ni0x0/diploma/Documentation/some_presentation_materials/1q.png

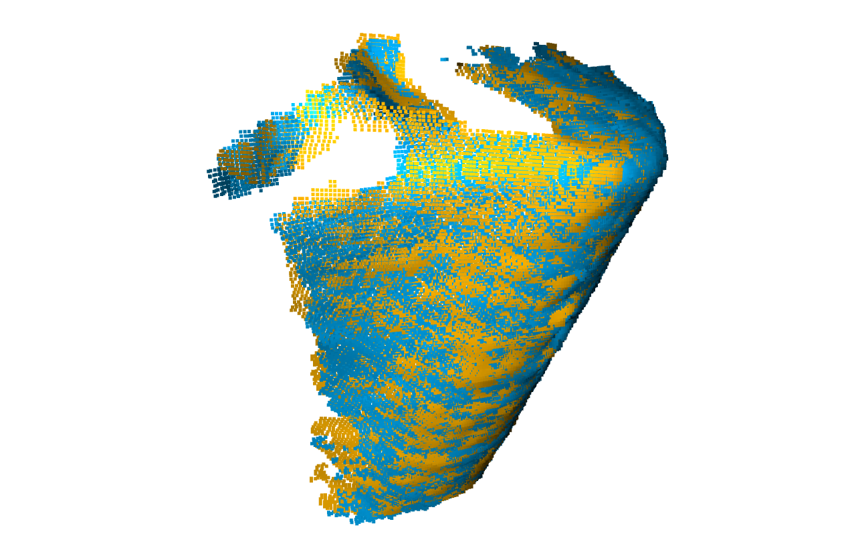
Documentation/some_presentation_materials/1q.png
