ni0x0/diploma/Documentation/some_presentation_materials/screen4.png

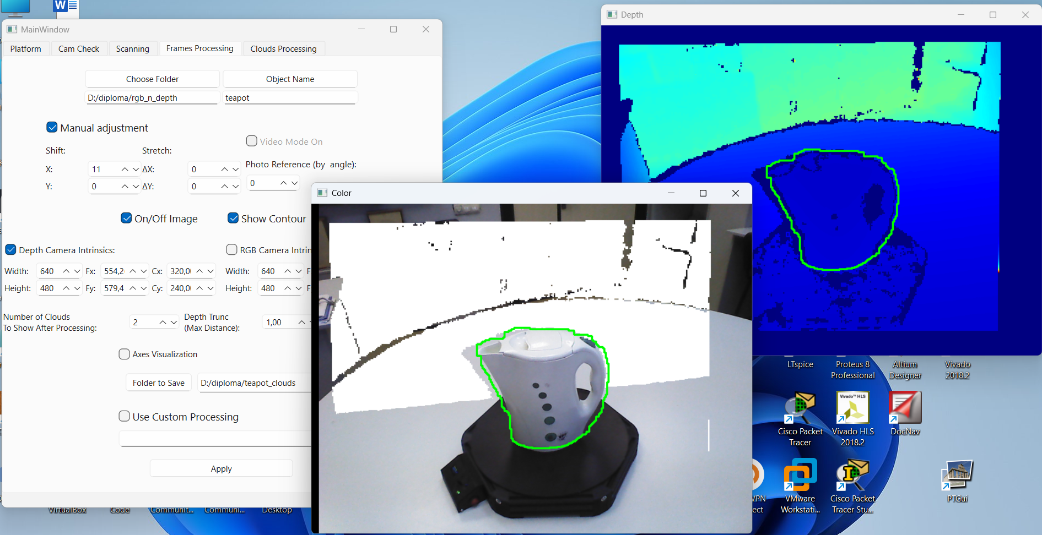
Documentation/some_presentation_materials/screen4.png
