ni0x0/diploma/3d_models_corrections/Readme.md

Тут именно мои модельки. Ссылки на оригиналы есть в записке
