ni0x0/diploma/Documentation/DiplomaNotes/11_Перечень элементов_2025.pdf

Изм. Лист | | № докум. | Подп. | Дата
Разраб. | Черноок | | | Программно-аппаратный комплекс для 3D сканирования объектов. Перечень элементов | Лит. | Лист | Листов
Пров. | Перцев | | | | | Т | | 1 | 2
Т. контр. | Перцев | | | | ЭВМ, гр. 150501
Н. контр. | Стракович
Утв. | Никульшин

## ГУИР.400201.099 ПЭ3

Поз. чение Зона обозна- | Наименование | Кол. | Примечание
| Конденсаторы
C1 | Конденсатор электролитический выводной 47uF
| 100V 10x12,5 105C / JRB2A470M05001000125000B | 1
С2 | Конденсатор многослойный 0.1uF 50V (Y5V) ±20%/
| TS170R1H104M8BFB0R | 1
C3 | Конденсатор электролитический выводной 100uF
| 16V 5x11 105C (JWCO) | 1
| Микросхемы
DD1 | DSM-OLEDv2-0.96-4P-YB, 0.96-дюймовый модуль с
| дисплеем OLED | 1
DD2 | Субмодуль DRV8825 / драйвер шагового
| двигателя | 1
DD3 | BMS 3S (12.6В 40A BALANCE) контроллер заряда
| с защитой и балансировкой на 3 АКБ | 1
DD4 | Модуль WROOM ESP32-S WiFi 4MB, 38 контактов | 1
DD5 | Модуль Mini-360 понижающий DC-DC
| преобразователь напряжения | 1
| Двигатели
M1 | Шаговый мотор NEMA 17HS8401-01 54 мм, 2А | 1
| Индикаторы
HL1 | Светодиод выводной BT-104GID-31-520G-B6 /
| зелёный | 1
HL2 | Светодиод выводной GNL-5013UBD-B /
| синий | 1

Изм. Лист | № докум. | Подп. | Дата

## ГУИР.400201.099 ПЭ3

Поз. чение Зона обозна- | Наименование | Кол. | Примечание
| Резисторы
R1, R2 | Резистор выводной 10K 0.25W ±5 %, CF1, 4W-10K | 2
R3, R4 | Резистор выводной 470 0.25W ±5 % | 2
RP1 | Резистор переменный осевой R-0904N-B100K L20 | 1

Лист
2
| Разъемы
XT1 | Клеммник винтовой DG126-5.0-02P-14-00AH | 2
| Устройства коммутации
SA1 | Переключатель клавишный RS-7201-C-C3 / с
| фиксацией, 250VAC, без подсветки красный | 1
SW1, SW2 KAN1211-1001B 12x12x10 mm Кнопка тактовая | | 2
