ni0x0/diploma/sketches/Readme.md

Код рабочий, но чуть-чуть не полный (вроде нет обработки пары команд)
