ni0x0/diploma/Documentation/DiplomaNotes/01.ТЛ по ПДП_2025.docx

Министерство образования Республики Беларусь

Учреждение образования

БЕЛОРУССКИЙ ГОСУДАРСТВЕННЫЙ УНИВЕРСИТЕТ

ИНФОРМАТИКИ И РАДИОЭЛЕКТРОНИКИ

Факультет компьютерных систем и сетей

Кафедра электронных вычислительных машин

Отчет по преддипломной практике

Студент А.Ю. Черноок

Руководитель Е.Э. Лойкуц

Консультант от кафедры ЭВМ Д.Ю. Перцев

Нормоконтролер А.И. Стракович

МИНСК 2025
