ni0x0/diploma/Documentation/DiplomaNotes/02.ТЛ_2025.pdf

Министерство образования Республики Беларусь

Учреждение образования
БЕЛОРУССКИЙ ГОСУДАРСТВЕННЫЙ УНИВЕРСИТЕТ ИНФОРМАТИКИ И РАДИОЭЛЕКТРОНИКИ

Факультет компьютерных систем и сетей

Кафедра электронных вычислительных машин

К защите допустить:
Заведующий кафедрой ЭВМ
___________ Б.В. Никульшин

ПОЯСНИТЕЛЬНАЯ ЗАПИСКА
к дипломному проекту
на тему

ПРОГРАММНО-АППАРАТНЫЙ КОМПЛЕКС ДЛЯ 3D СКАНИРОВАНИЯ ОБЪЕКТОВ

БГУИР ДП 1–40 02 01 01 099 ПЗ

Студент | А.Ю. Черноок
Руководитель | Д.Ю. Перцев

Консультанты:

от кафедры ЭВМ | Д.Ю. Перцев
по экономической части | В.Г. Горовой
Нормоконтролер | А.И. Стракович

Рецензент

МИНСК 2025

Решением рабочей комиссии
допущен(а) к защите дипломного проекта Председатель рабочей комиссии

_______________ ( ___________________ )

Подпись | Инициалы и фамилия
«___» ________ 2025 г.
