ni0x0/diploma/Documentation/DiplomaNotes/05.плакат_2025.pdf

# ПРОГРАММНО-АППАРАТНЫЙ КОМПЛЕКС ДЛЯ 3D СКАНИРОВАНИЯ ОБЪЕКТОВ

## Цель проекта:

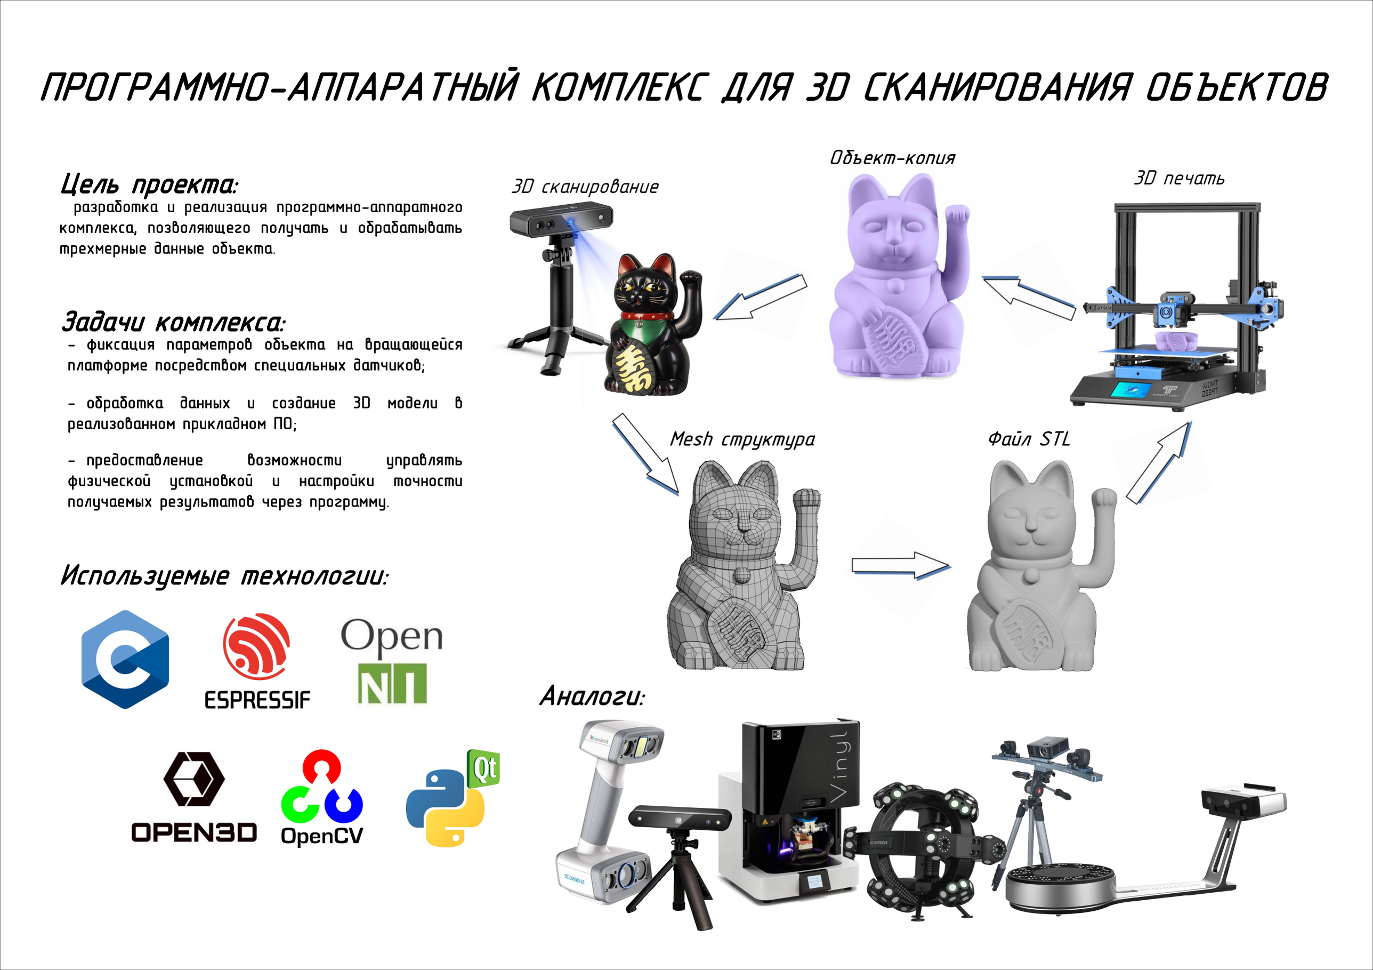
[picture p89: page 1]

## Используемые технологии:

## Аналоги:

### 3D сканирование

### 3D печать

Mesh структура | Файл STL

### Объект-копия

разработка и реализация программно-аппаратного комплекса, позволяющего получать и обрабатывать трехмерные данные объекта.

## Цель проекта:

разработка и реализация программно-аппаратного комплекса, позволяющего получать и обрабатывать трехмерные данные объекта.

## Задачи комплекса:

–шфиксация параметров объекта на вращающейся платформе посредством специальных датчиков;

–шпредоставление | возможности | управлять
физической | установкой | и | настройки | точности
получаемых результатов через программу.

–шобработка данных и создание 3D модели в реализованном прикладном ПО;

–шфиксация параметров объекта на вращающейся платформе посредством специальных датчиков;

–шпредоставление | возможности | управлять
физической | установкой | и | настройки | точности
получаемых результатов через программу.

–шобработка данных и создание 3D модели в реализованном прикладном ПО;

## Задачи комплекса:

–шфиксация параметров объекта на вращающейся платформе посредством специальных датчиков;

–шпредоставление | возможности | управлять
физической | установкой | и | настройки | точности
получаемых результатов через программу.

–шобработка данных и создание 3D модели в реализованном прикладном ПО;

## Цель проекта:

разработка и реализация программно-аппаратного комплекса, позволяющего получать и обрабатывать трехмерные данные объекта.

## Задачи комплекса:

–шфиксация параметров объекта на вращающейся платформе посредством специальных датчиков;

–шпредоставление | возможности | управлять
физической | установкой | и | настройки | точности
получаемых результатов через программу.

–шобработка данных и создание 3D модели в реализованном прикладном ПО;

| | | | | ГУИР.400201.099 ПЛ.1 ГУИР.400201.099 ПЛ.1
| | | | | Вводный плакат. Плакат Вводный плакат. Плакат | Лит. Лит. | Масса Масса | Масштаб Масштаб
Изм. | Лист Лист | № докум. № докум. | Подп. Подп. | Дата Дата | | | Т Т
Разраб. Разраб. | | Черноок Черноок
Пров. Пров. | | Перцев Перцев
Т. контр. Т. контр. | Перцев Перцев | | | | Лист Лист | Листов Листов 1 1
Реценз. Реценз. | | | | | ЭВМ, гр. 150501 ЭВМ, гр. 150501
Н. контр. Н. контр. | Стракович Стракович
Утв. Утв. | Никульшин Никульшин
