ni0x0/diploma/Documentation/DiplomaNotes/06_v2_структурная_x2.pdf

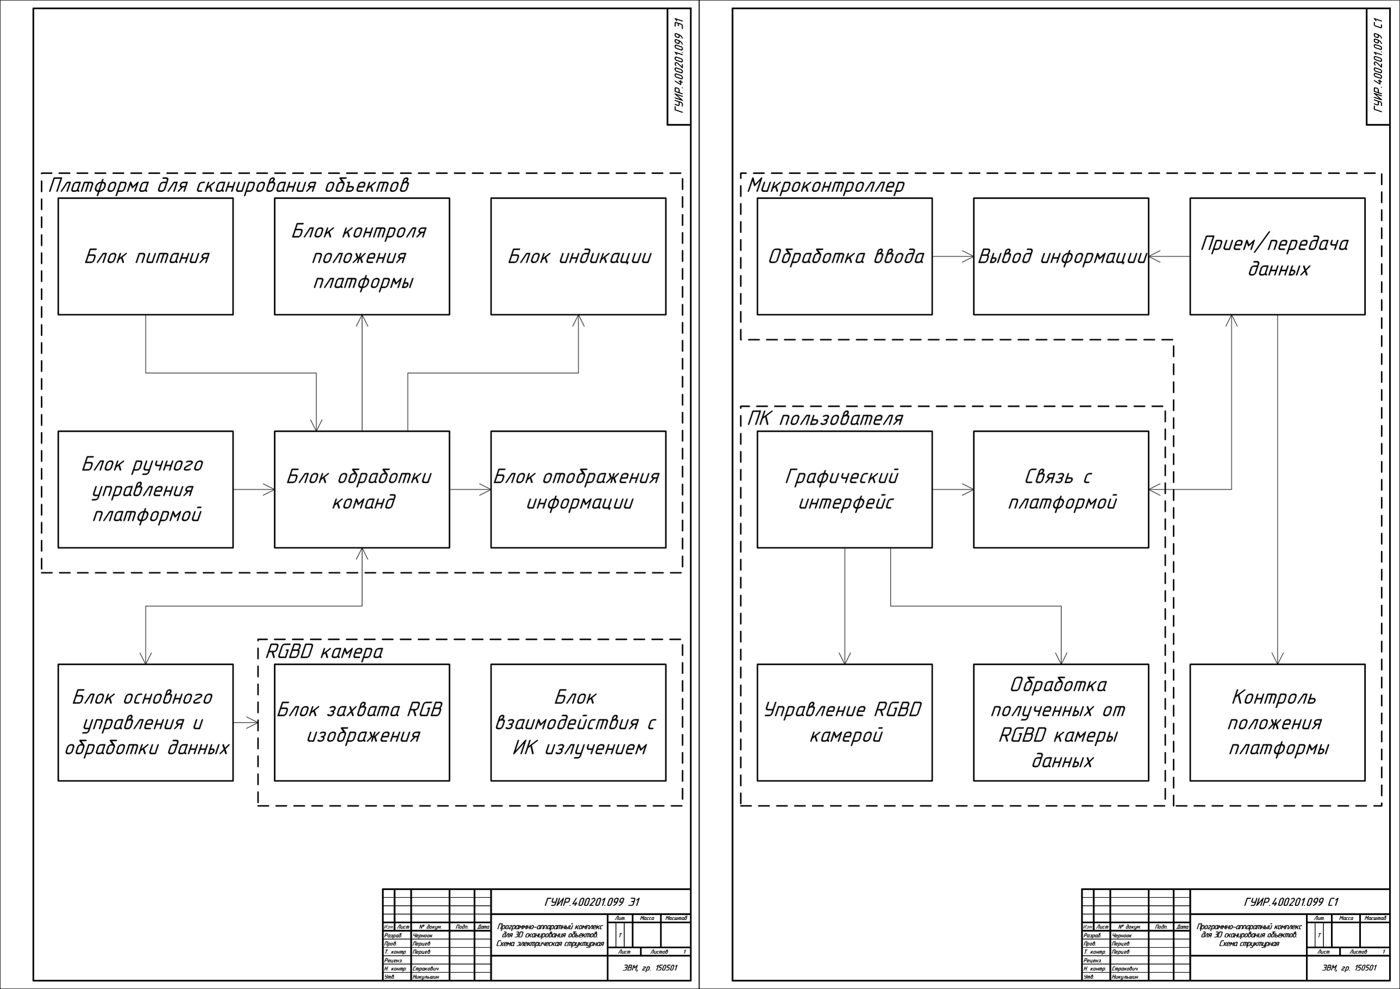
[picture p90: figure]
Лист; № докум.; Подп.; Дата; Разраб.; Пров.; Т. контр.; Н. контр.; Утв.; Черноок; Реценз.; Перцев; Программно-аппаратный комплекс для 3D сканирования объектов. Схема электрическая структурная; ГУИР.400201.099 Э1; Лит.; Масса; Масштаб; Листов; ЭВМ, гр. 150501; Стракович; Никульшин; Программно-аппаратный комплекс для 3D сканирования объектов. Схема структурная; ГУИР.400201.099 С1; Изм.; Блок индикации; Блок контроля положения платформы; Блок отображения информации; Блок обработки команд; Блок ручного управления платформой; Блок взаимодействия с ИК излучением; Блок захвата RGB изображения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
