ni0x0/diploma/Documentation/DiplomaNotes/12_монтажный.pdf

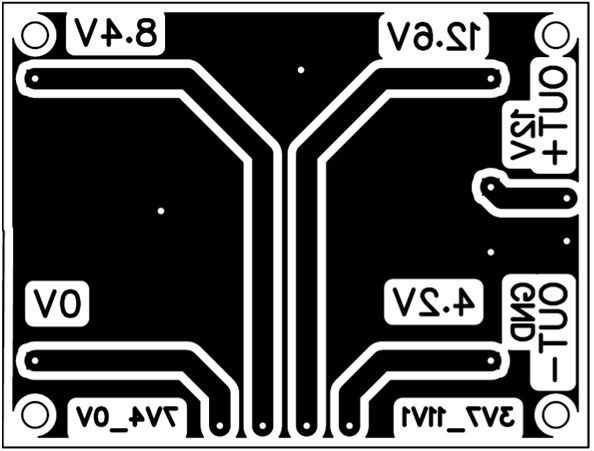
[picture p91: figure]
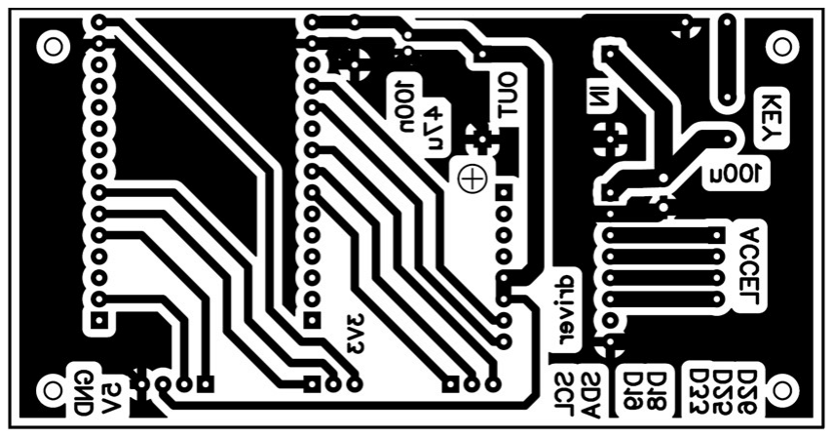
[picture p92: figure]
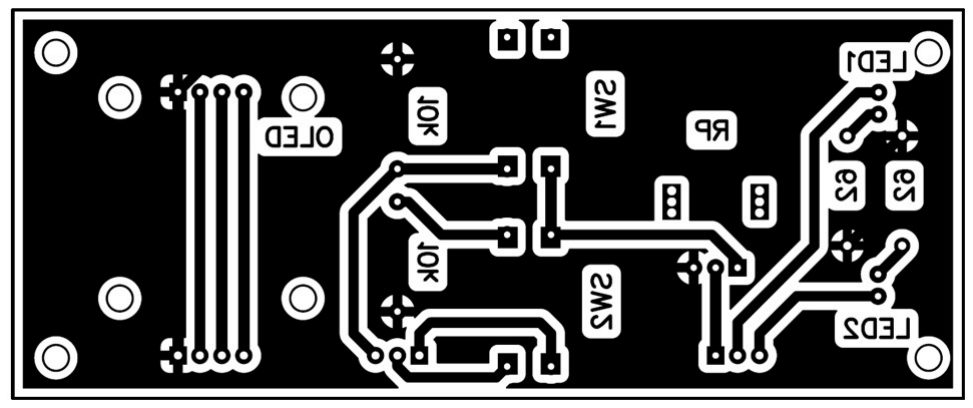
[picture p93: figure]

| | | | | ГУИР.400201.099 МЭ
| | | | | Программно-аппаратный комплекс для 3D сканирования объектов. Чертеж электромонтажный | Лит. | Масса | Масштаб
Изм. Лист | | № докум. | Подп. | Дата | | | Т | | 1:1
Разраб. | | Черноок
Пров. | | Перцев
Т. контр. | Перцев | | | | Лист | Листов 1
Реценз. | | | | | ЭВМ, гр. 150501
Н. контр. | Стракович
Утв. | Никульшин

Плата для установки BMS 3S

Плата с разведением питания и микроконтроллером

Плата «панели управления»
