ni0x0/diploma/Documentation/DiplomaNotes/13_Спецификация_2025.pdf

Изм. | Лист | № докум. | Подп. | Дата
Разраб. | Черноок | | | Программно-аппаратный комплекс для 3D сканирования объектов. Спецификация | Лит. | Лист | Листов
Пров. | Перцев | | | | | Т | | 1
Т. контр. | Перцев | | | | ЭВМ, гр. 150501
Н. контр. | Стракович
Утв. | Никульшин

## ГУИР.400201.099 Д2

Обозначение | Наименование | Примечание
| Документация
12-01 | Исходный код для | В составе пояснительной записки
| микроконтроллера
12-01 | | В составе пояснительной записки Исходный код
| прикладного ПО
81-01 | Пояснительная записка | В составе пояснительной записки
90-01 | Руководство пользователя | В составе пояснительной записки

Компоненты
3DScanPlatform.zip.
Архивный файл | На DVD-R диске «CharnavokAY»
3DScanPlatform_Source.zip.
Архивный файл | На DVD-R диске «CharnavokAY»
astra-win32-driver-4.3.0.22.zip.
Архивный файл | На DVD-R диске «CharnavokAY»
esp32.zip.
Архивный файл | На DVD-R диске «CharnavokAY»
presentation.pptx.
Мультимедийный файл | На DVD-R диске «CharnavokAY»
Readme.txt.
Текстовый файл | На DVD-R диске «CharnavokAY»
