ni0x0/diploma/Documentation/DiplomaNotes/14_Ведомость_2025.pdf

Изм. Лист | | № докум. | Подп. | Дата
Разраб. | Черноок | | | Программно-аппаратный комплекс для 3D сканирования объектов. Ведомость документов | Лит. | Лист | Листов
Пров. | Перцев | | | | | Т | | 1 | 2
Т. контр. | Перцев | | | | ЭВМ, гр. 150501
Н. контр. | Стракович
Утв. | Никульшин

## БГУИР ДП 1–40 02 01 099 Д1

Обозначение | Наименование | Примечание
| Графические документы
ГУИР.400201.099 МЭ | Программно-аппаратный комплекс для 3D
| сканирования объектов. | Формат А4,
| Чертеж электромонтажный | в ПЗ
ГУИР.400201.099 ПД.1 | Программно-аппаратный комплекс для 3D
| сканирования объектов: ПО микроконтроллера.
| Схема программы | Формат А1
ГУИР.400201.099 ПД.2 | Программно-аппаратный комплекс для 3D
| сканирования объектов: прикладное ПО.
| Схема программы | Формат А1
ГУИР.400201.099 ПЛ.1 | Вводный плакат. Плакат | Формат А1
ГУИР.400201.099 ПЛ.2 | Заключительный плакат. Плакат | Формат А1
ГУИР.400201.099 С1 | Программно-аппаратный комплекс для 3D
| сканирования объектов.
| Схема структурная | Формат А2
ГУИР.400201.099 Э1 | Программно-аппаратный комплекс для 3D
| сканирования объектов.
| Схема электрическая структурная | Формат А2
ГУИР.400201.099 Э2 | Программно-аппаратный комплекс для 3D
| сканирования объектов.
| Схема электрическая функциональная | Формат А2
ГУИР.400201.099 Э3 | Программно-аппаратный комплекс для 3D
| сканирования объектов.
| Схема электрическая принципиальная | Формат А2
| Текстовые документы
БГУИР ДП 1–400201 01 099 ПЗ | | 151 с. Пояснительная записка

Изм. Лист | № докум. | Подп. | Дата

## БГУИР ДП 1–40 02 01 099 Д1

Лист
2
Обозначение | Наименование | Примечание
ГУИР.400201.099 Д2 | Программно-аппаратный комплекс для 3D
| сканирования объектов.
| Спецификация | 1 л., в ПЗ
ГУИР.400201.099 ПЭ3 | Программно-аппаратный комплекс для 3D
| сканирования объектов.
| Перечень элементов | 2 л., в ПЗ
| Отзыв руководителя
| Отчет проверки на заимствования
| Рецензия
