ni0x0/diploma/Documentation/DiplomaNotes/15_закл_плакат_2025.pdf

# ПРОГРАММНО-АППАРАТНЫЙ КОМПЛЕКС ДЛЯ 3D СКАНИРОВАНИЯ ОБЪЕКТОВ

## Достоинства:

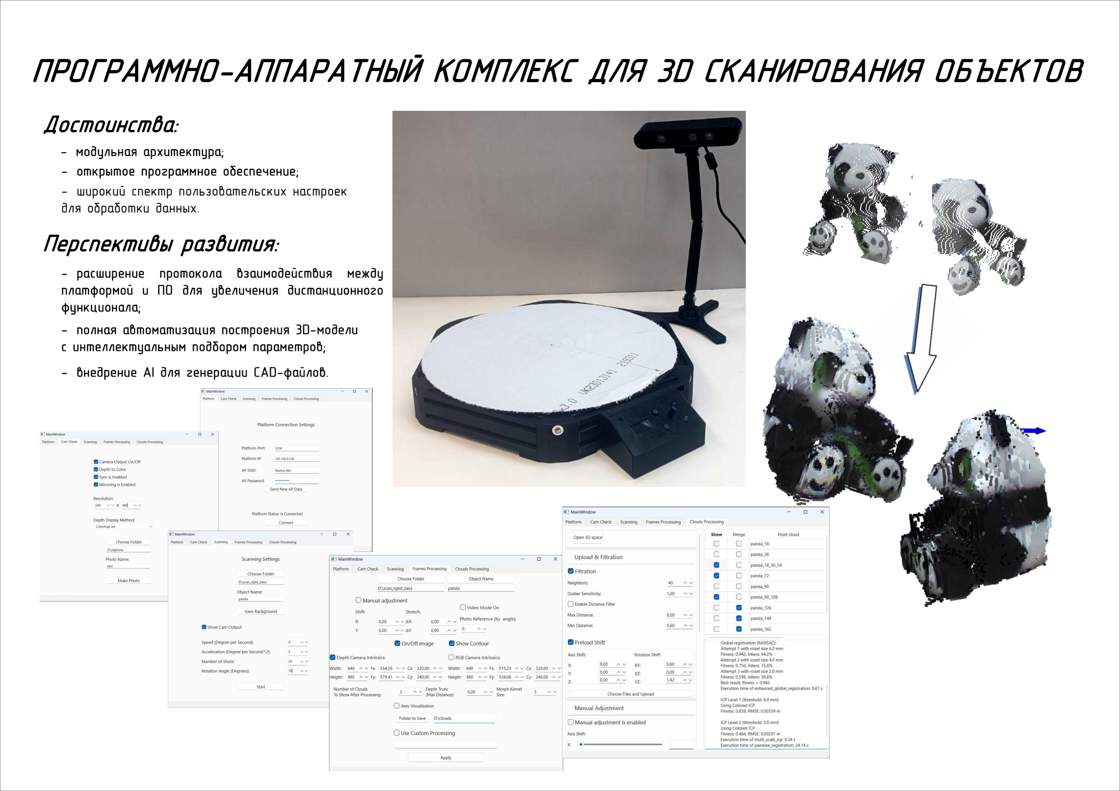
[picture p94: page 1]

## Перспективы развития:

–шрасширение протокола взаимодействия между платформой и ПО для увеличения дистанционного функционала;

–швнедрение AI для генерации CAD-файлов.

–шполная автоматизация построения 3D-модели
с интеллектуальным подбором параметров;

–шрасширение протокола взаимодействия между платформой и ПО для увеличения дистанционного функционала;

–швнедрение AI для генерации CAD-файлов.

–шполная автоматизация построения 3D-модели
с интеллектуальным подбором параметров;

–шмодульная архитектура;
–шоткрытое программное обеспечение;

–шмодульная архитектура;
–шоткрытое программное обеспечение; –шширокий спектр пользовательских настроек для обработки данных.

| | | | | ГУИР.400201.099 ПЛ.2 ГУИР.400201.099 ПЛ.2
| | | | | Заключительный плакат. Плакат Заключительный плакат. Плакат | Лит. Лит. | Масса Масса | Масштаб Масштаб
Изм. | Лист Лист | № докум. № докум. | Подп. Подп. | Дата Дата | | | Т Т
Разраб. Разраб. | | Черноок Черноок
Пров. Пров. | | Перцев Перцев
Т. контр. Т. контр. | Перцев Перцев | | | | Лист Лист | Листов Листов 1 1
Реценз. Реценз. | | | | | ЭВМ, гр. 150501 ЭВМ, гр. 150501
Н. контр. Н. контр. | Стракович Стракович
Утв. Утв. | Никульшин Никульшин
