ni0x0/diploma/Documentation/DiplomaNotes/антиплагиат_стр.pdf

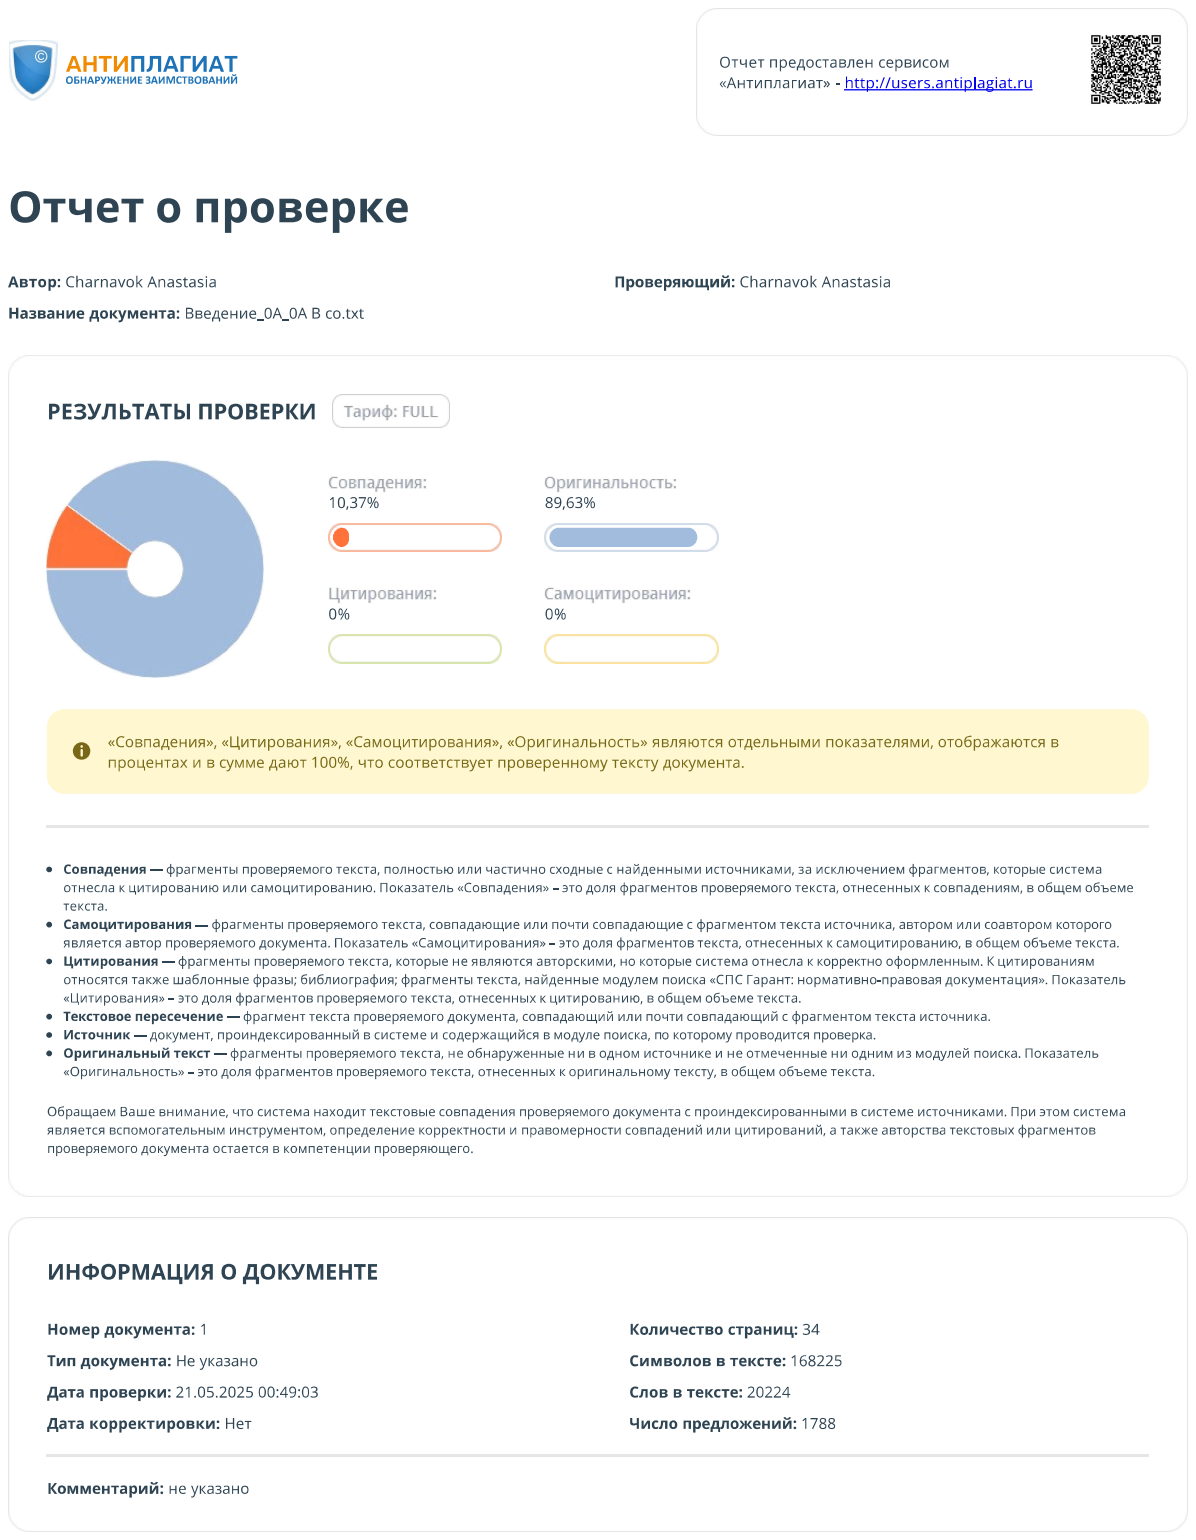
[picture p95: page 1]
