ni0x0/diploma/project/panda_photos/apan_color_90.png

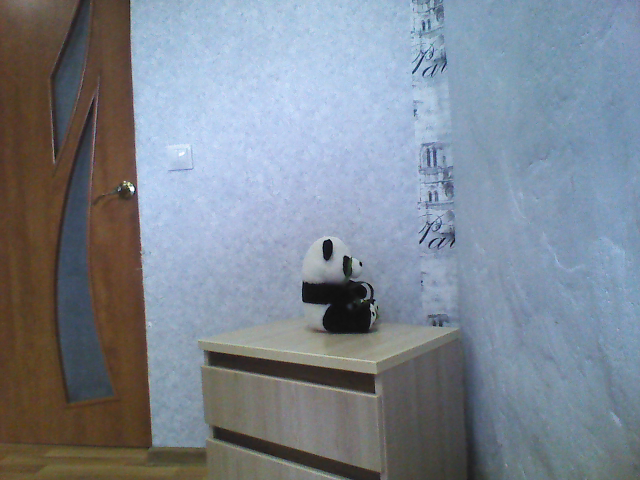
project/panda_photos/apan_color_90.png
