ni0x0/diploma/project/panda_photos/apan_color_120.png

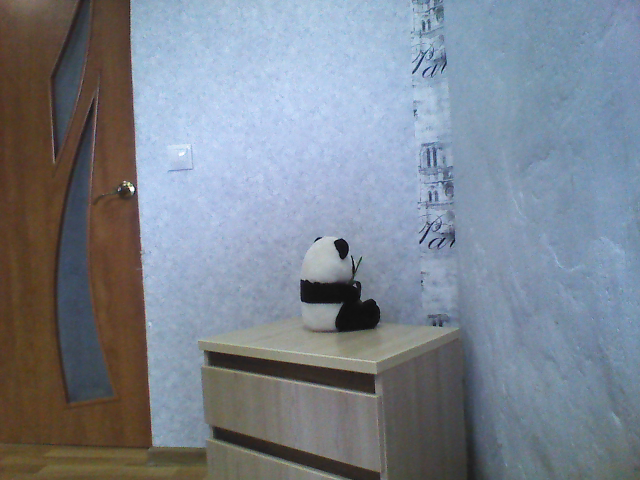
project/panda_photos/apan_color_120.png
