ni0x0/diploma/project/panda_photos/apan_color_180.png

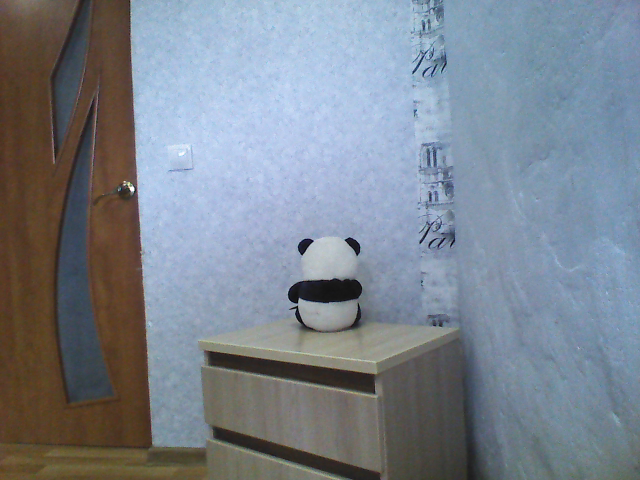
project/panda_photos/apan_color_180.png
