ni0x0/diploma/project/panda_photos/apan_color_background.png

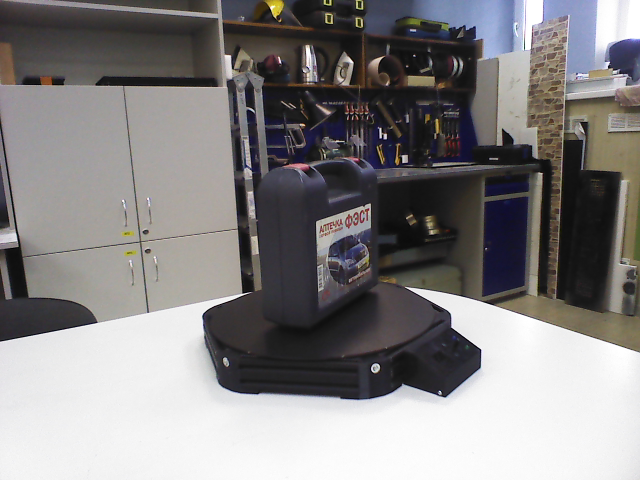
project/panda_photos/apan_color_background.png
