ni0x0/diploma/project/rgb_n_depth/teapot_color_0.png

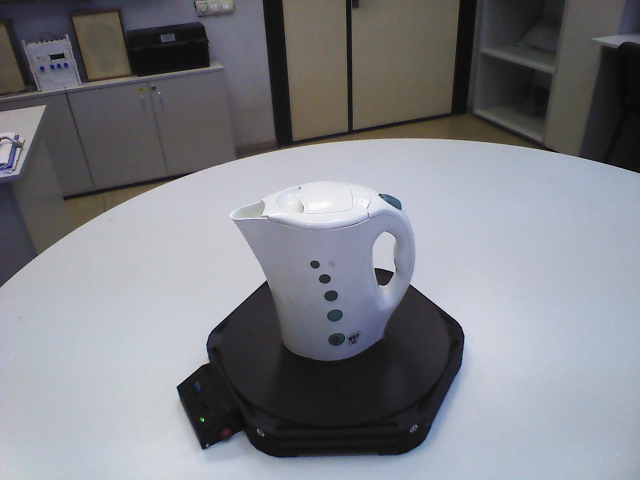
project/rgb_n_depth/teapot_color_0.png
