ni0x0/diploma/project/rgb_n_depth/teapot_color_100.png

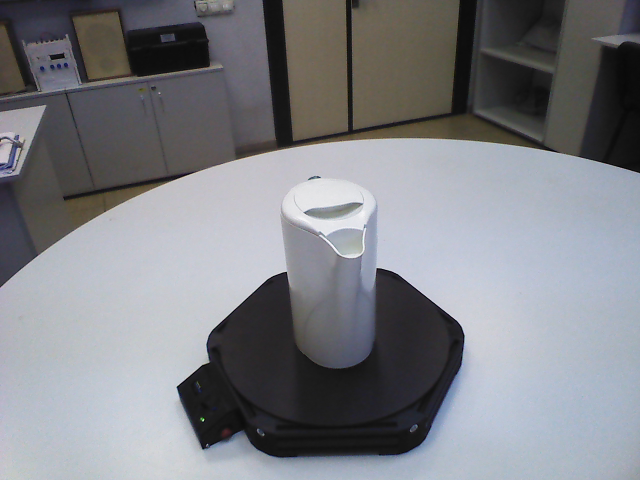
project/rgb_n_depth/teapot_color_100.png
