ni0x0/diploma/Documentation/some_presentation_materials/планкапкан.docx

Слайд 1

Добрый день, уважаемые члены комиссии. Я представляю свой проект “Программно-аппаратный комплекс для 3D сканирования объектов”

Слайд 2

Цель данной работы – “Разработка и реализация программно-аппаратного комплекса, позволяющего получать и обрабатывать трехмерные данные объекта”

К задачам комплекса относятся:

• Фиксация параметров объекта на платформе c помощью rgbd камеры

• Обработка полученных данных и создание 3D моделей

• Управление физической установкой

Слайд 3

Из представленных технологий отдельно выделим:

• OpenNI (Open Natural Interaction) – программный фреймворк, предназначенный для работы на низком уровне со специализированными физическими устройствами

• OpenCV – это библиотека алгоритмов компьютерного зрения. В данной работе использовалась для выравнивания изображений и обнаружения объектов

• Open3D – библиотека для работы с 3D данными. Включает в себя поддержку различных 3D структур и алгоритмов их обработки, необходимых для таких задач, как например реконструкция сцен или выравнивание поверхностей

Слайд 4

В качестве главного устройства для сбора данных была использована RGBD камера Orbec Astra, главной особенностью которой является возможность получения как цифровых (RGB) снимков, так и снимков глубины.

Слайд 5

Для проверки работоспособности камеры и первого знакомства с ней, использовалась утилита NIViewer. Слева представлен вывод камеры глубины, а справа – rgb камеры в градациях серого

Слайд 6

Для аппаратной установки были спроектированы схемы, вначале собранные на макетной плате, а позднее были вытравлены следующие платы:

• плата под BMS модуль для защиты аккумуляторов от ухода в глубокий разряд и балансировки напряжения на них.

• плата разведением питания для логической и силовой составляющих. именно на ней установлены модуль с микроконтроллером esp32-wroom dev kit, драйвер для управления шаговым двигателем drv8825, а также к ней подключается непосредственно шаговый двигатель nema17 (HS8401)

• и плата для панели управления, на который установлены oled дисплей диагональю 0.96 дюймов, потенциометр, кнопки и светодиоды. Зеленый информирует о том, что устройство включено, синий загорается во время движения шагового двигателя.

Также были смоделированы и напечатаны детали, произведена сборка корпуса.

Слайд 7

Платформа имеет 5 режимов работы. Выбор происходит с помощью потенциометра, а переключение по нажатию на нижнюю кнопку панели.

В настройках подключения выводится информация о соединении. Пункт с тестированием шагового двигателя позволяет проверить вращение платформы на разных скоростях, где скорость задается потенциометром. В пункте меню «Сканирование» можно увидеть соответствующую информацию о статусе и прогрессе. Информация об устройстве содержит названия основных компонентов.

Верхняя кнопка панели используется для специальных действий в отдельных пунктах меню: переключение между режимами точки доступа и подключения к сети пользователя, запуск/остановка движения в режиме теста двигателя, переключение между выводом углов и номера позиции в режиме сканирования.

Слайд 8

О прикладном ПО. Оно представляет собой инструмент для управления подключением к платформе, настройками камеры, параметрами сканирования, а также базовой обработкой 2D и 3D данных. Разработано с использованием PyQt для графического интерфейса, OpenNI – для задания параметров камеры и сбора данных с нее, OpenCV – для обработки цветных и глубинных изображений, а также Open3D – для получения, визуализации и обработки облаков точек

Слайд 9.

Данное видео демонстрирует непосредственно процесс сканирования, где выполняется сбор снимков объекта с разных ракурсов.

Как только выполняется первая пара снимков, платформе посылается команда с информацией о том, сколько необходимо будет сделать поворотов и на какой угол. После ожидается ответ.

Как только платформа повернулась, она посылает сообщение, сигнализирующее о том, что можно делать следующую пару снимков.

Далее действия повторяются до тех пор, пока не будет сделано заданное число снимков, единственное отличие –платформе отправляется только команда сделать очередной поворот.

Стоит отметить, что параметры камеры были заданы заранее в другой вкладке. Среди них синхронизация потоков, наложение карты глубины на цветное изображение, зеркальное отображение и способ визуализации глубины. Данные с камеры глубины не имеют цвета, только значение расстояния до точки. То, что мы видим – это визуализация с помощью средств opencv

Слайд 10

Далее можем увидеть, как происходит выделение объекта, а также визуализацию порога дальности.

Слайд 11

Совмещая данные rgb и глубины, мы получаем и сохраняем облака точек

Слайд 12

После чего выполняется их обработка как по отдельности для каждого, так и попарная, которая может включать в себя:

- Вокселизацию
- Фильтрацию
- Глобальную регистрацию
- ICP регистрацию
- Постобработку

Слайд 13

На видео демонстрируется результат проведения регистрации облаков. Так как при их создании началом координат считается позиция камеры, для каждого было выполнено смещение и поворот по заданным параметрам, чтобы приблизить к осям, далее поворот облака, соответствующий повороту платформы.

Также предобработка каждого и только после – попарная регистрация, по результату которой получаем уже одно совмещенное облако. Результат можно сохранить как в формате облака точек, так и построить на его основе mesh

Слайд 14

На слайде видим непосредственно примеры подобного преобразования и экспорта

Слайд 15

Подводя итоги из достоинств комплекса выделить: модульную архитектуру, открытое программное обеспечение и широкий спектр пользовательских настроек для обработки данных. Из возможных перспектив развития: расширение протокола взаимодействия между установкой и ПО, полную автоматизацию построения 3D-модели, использование искусственного интеллекта для генерации CAD-файлов.

Слайд 16

Спасибо за внимание.
