ni0x0/diploma/Documentation/some_presentation_materials/1.png

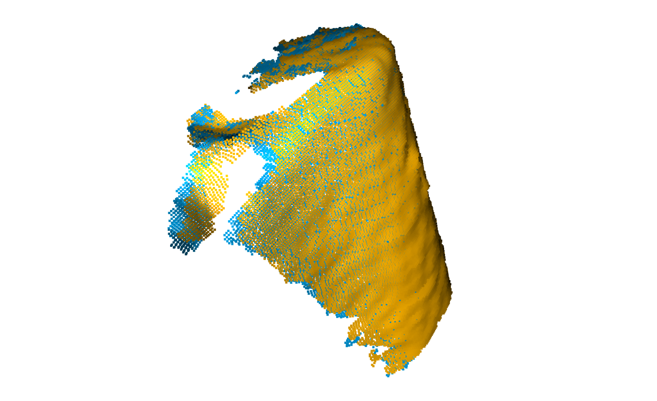
Documentation/some_presentation_materials/1.png
