ni0x0/diploma/Documentation/some_presentation_materials/2q.png

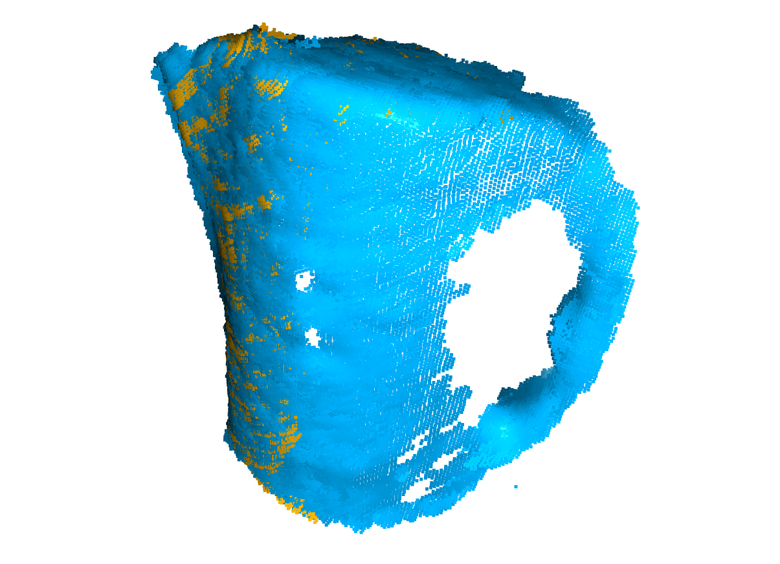
Documentation/some_presentation_materials/2q.png
