ni0x0/diploma/Documentation/some_presentation_materials/3.png

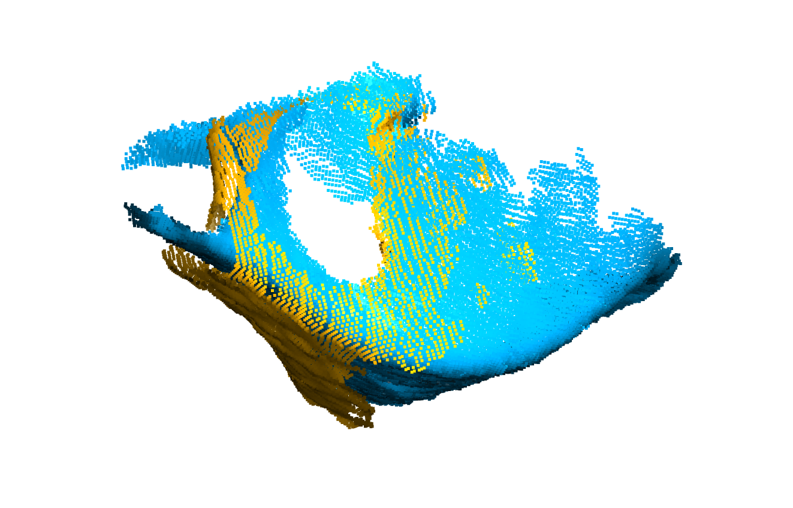
Documentation/some_presentation_materials/3.png
