ni0x0/diploma/Documentation/some_presentation_materials/3q.png

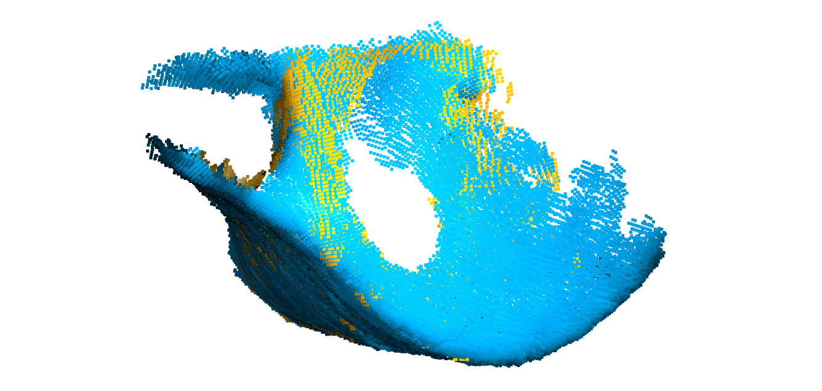
Documentation/some_presentation_materials/3q.png
