ni0x0/diploma/Documentation/some_presentation_materials/4.png

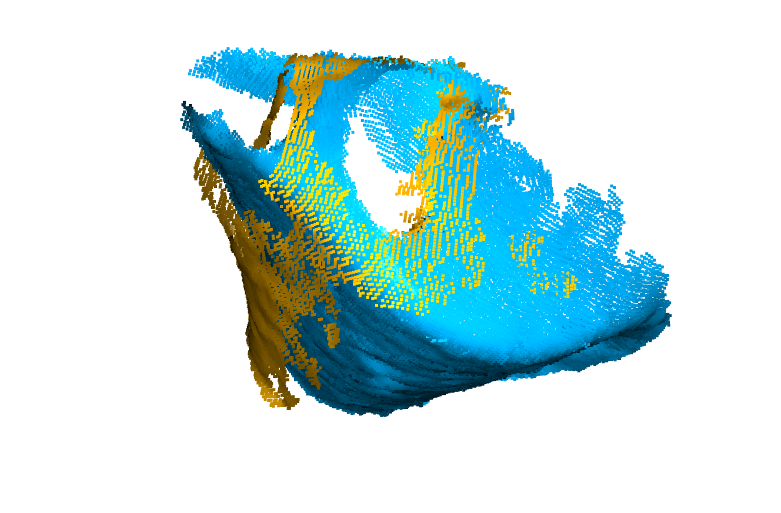
Documentation/some_presentation_materials/4.png
