ni0x0/diploma/Documentation/some_presentation_materials/screen1.png

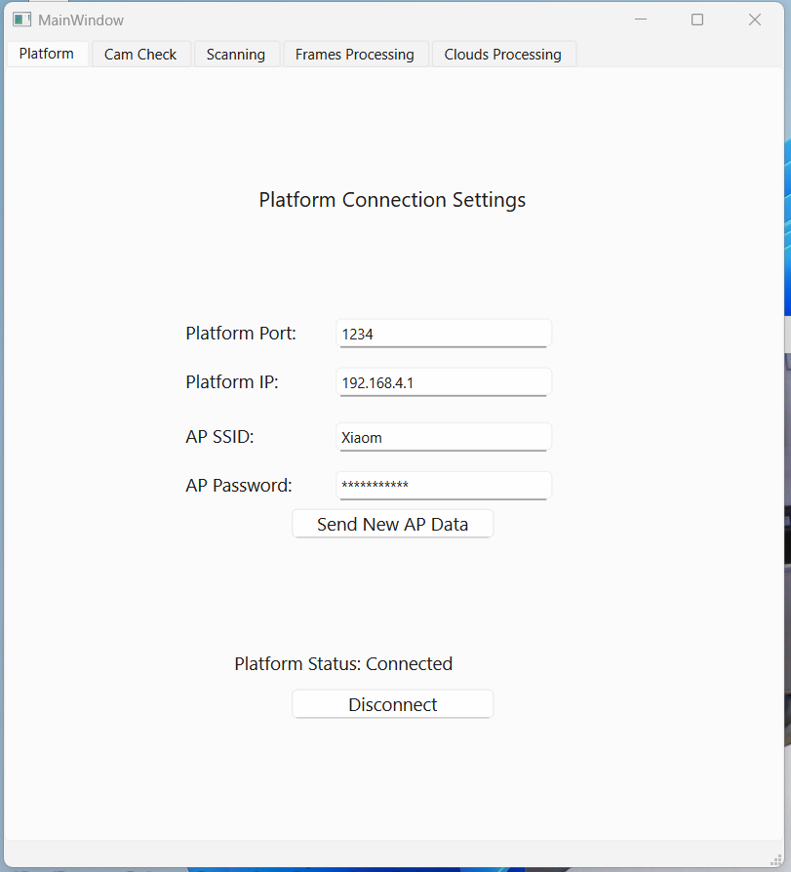
Documentation/some_presentation_materials/screen1.png
