ni0x0/diploma/Documentation/some_presentation_materials/screen2.png

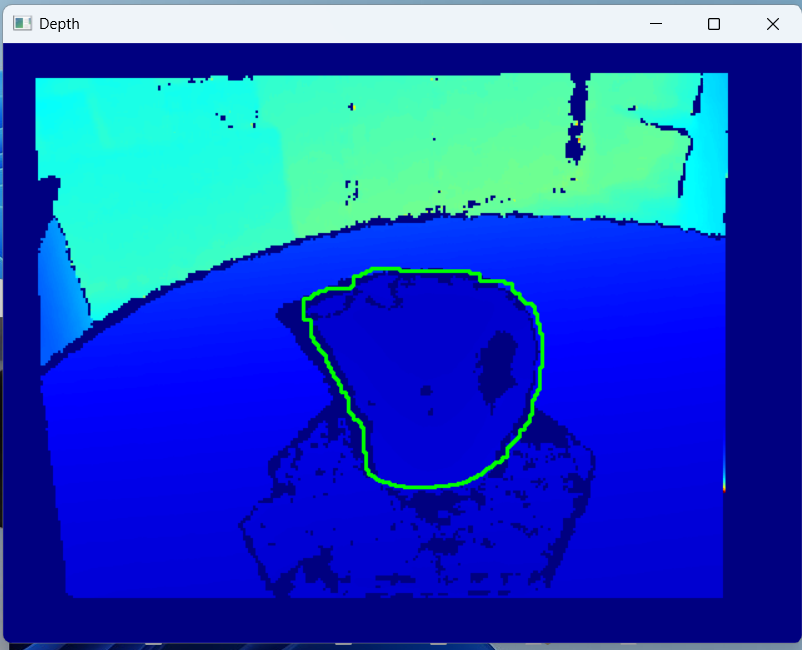
Documentation/some_presentation_materials/screen2.png
