ni0x0/diploma/Documentation/some_presentation_materials/screen3.png

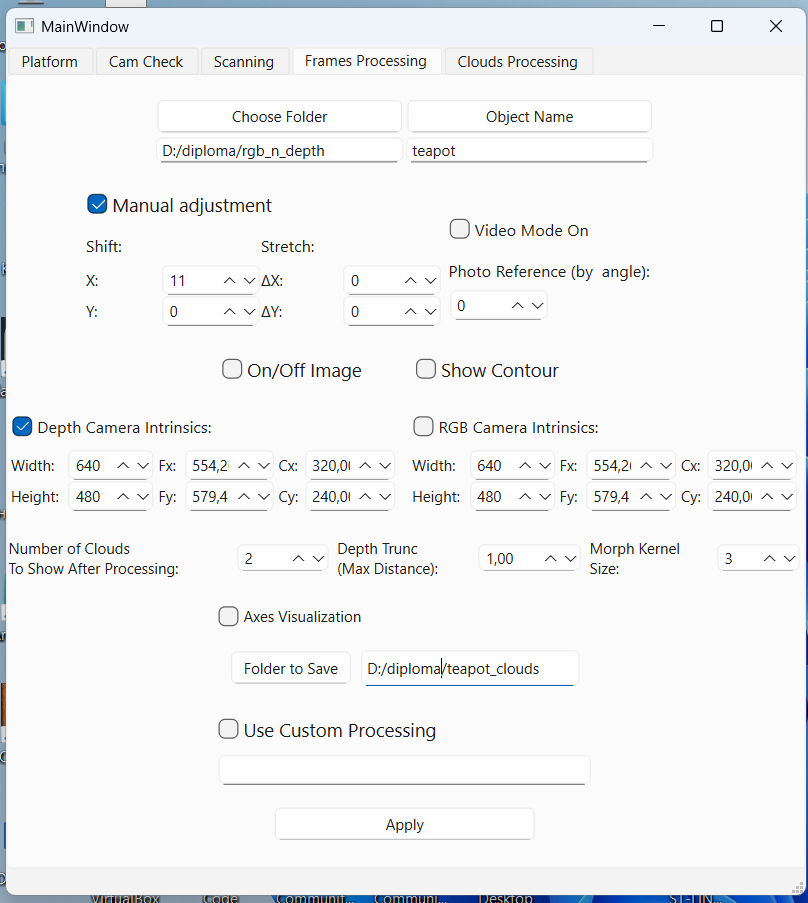
Documentation/some_presentation_materials/screen3.png
