ni0x0/diploma/Documentation/some_presentation_materials/screen6.png

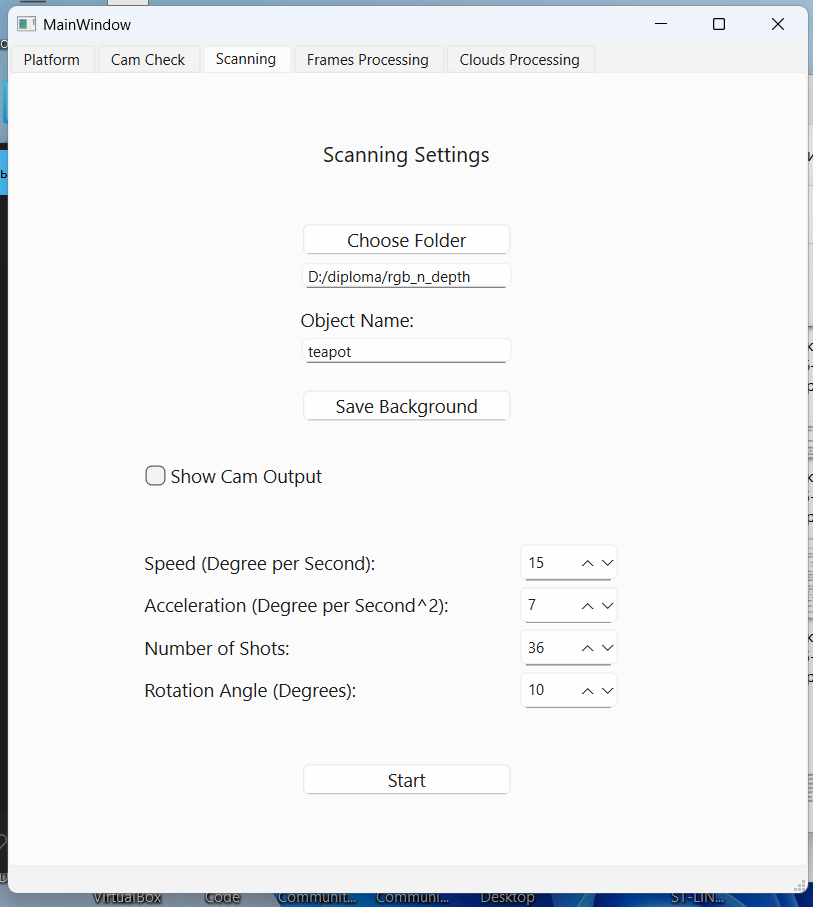
Documentation/some_presentation_materials/screen6.png
