ni0x0/diploma/Documentation/some_presentation_materials/старые конфиги без фильтрации.png

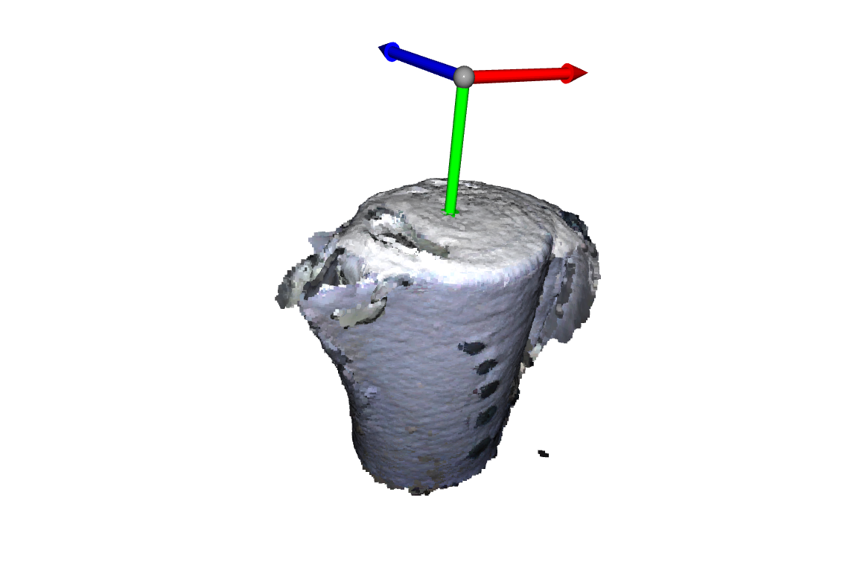
Documentation/some_presentation_materials/старые конфиги без фильтрации.png
