ni0x0/diploma/3d_models_corrections/tripod_base.stl

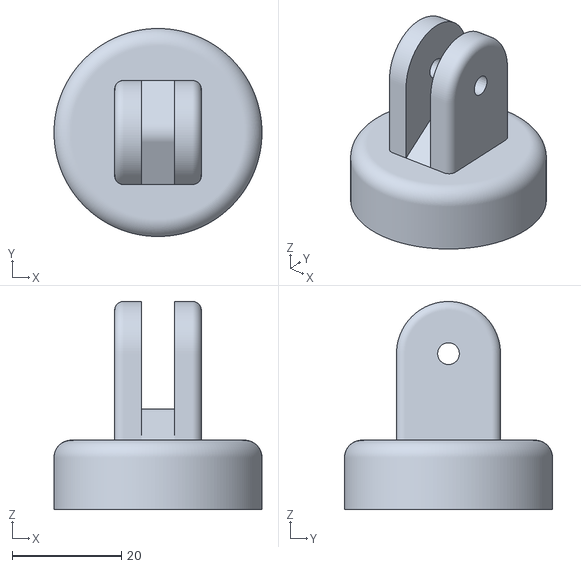
[picture p119: CAD file, 2025-10-06]
3d_models_corrections/tripod_base.stl
38.1 x 38.1 x 38.1
