ni0x0/diploma/3d_models_corrections/motor_holder.FCStd

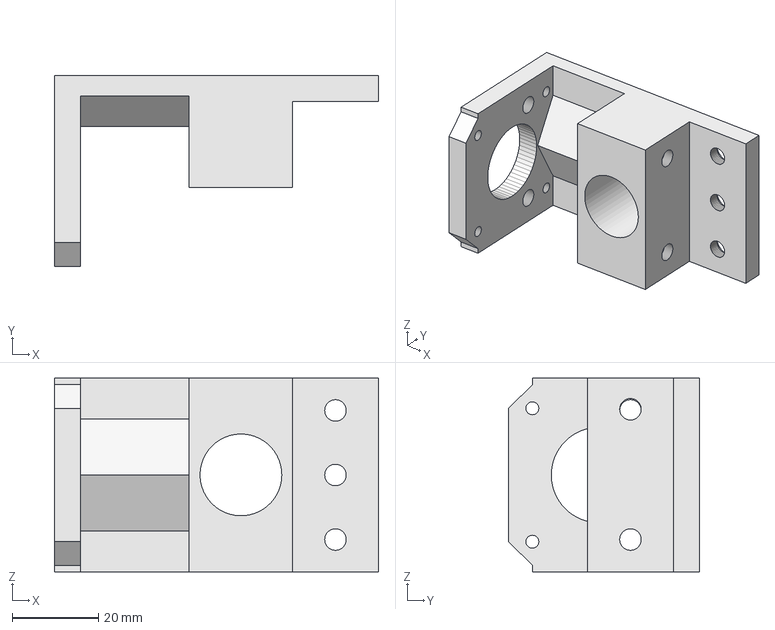
[picture p120: CAD file, 2025-10-06]
3d_models_corrections/motor_holder.FCStd
75.3 x 44.3 x 45.0 mm
