ni0x0/diploma/3d_models_corrections/scaner_center.FCStd

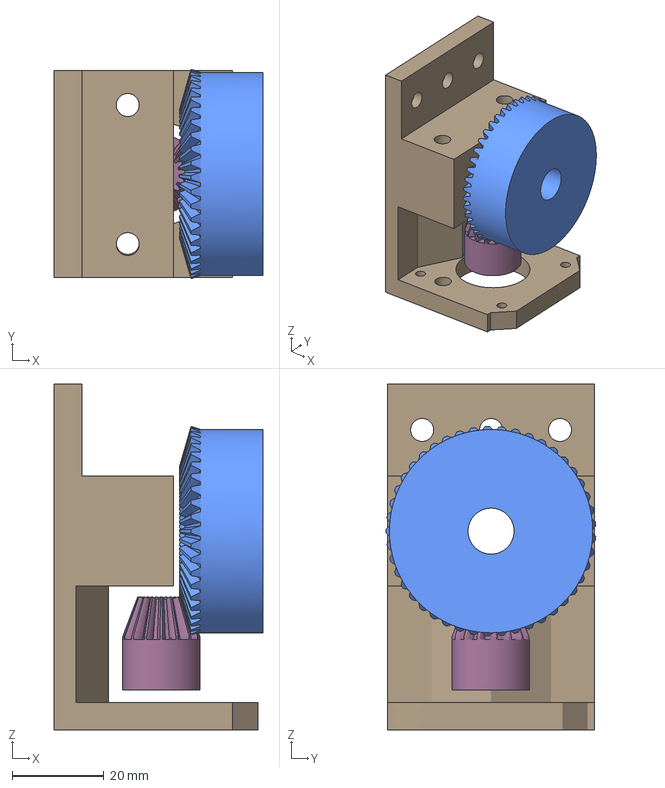
[picture p121: CAD file, 2025-10-06]
3d_models_corrections/scaner_center.FCStd
45.4 x 45.6 x 75.3 mm
gearbox
Kegelrad_45_1
Kegelrad_15_0
