ni0x0/diploma/3d_models_corrections/tripod_holder.stl

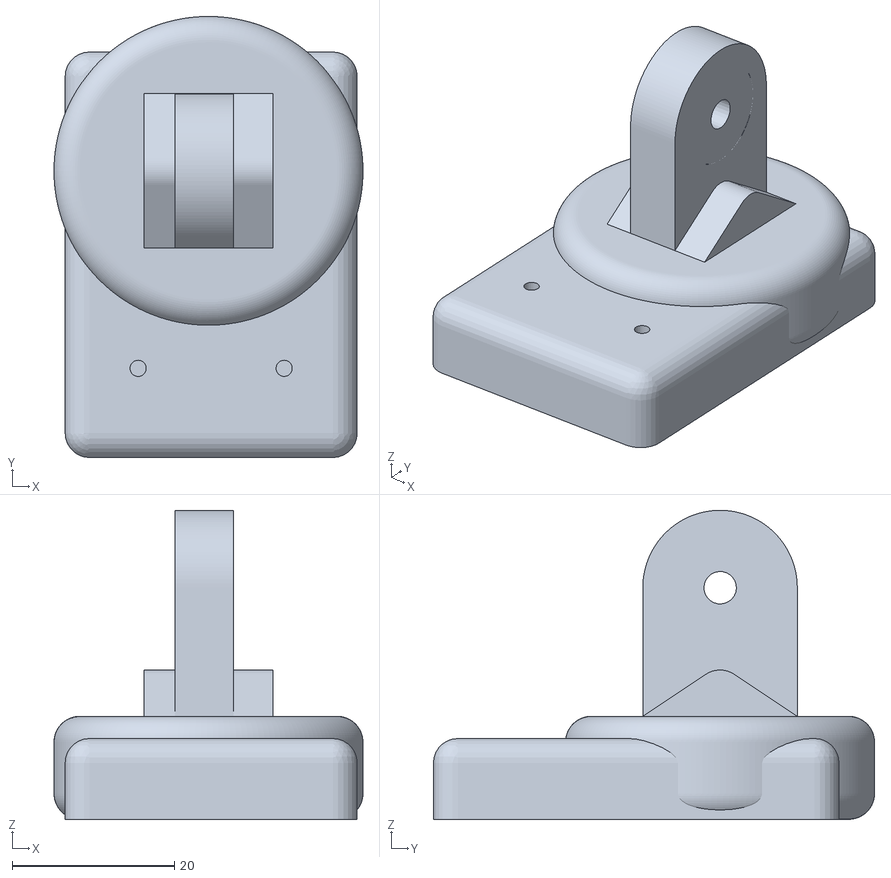
[picture p122: CAD file, 2025-10-06]
3d_models_corrections/tripod_holder.stl
38.1 x 54.4 x 38.1
