ni0x0/diploma/3d_models_corrections/tripod_arm.stl

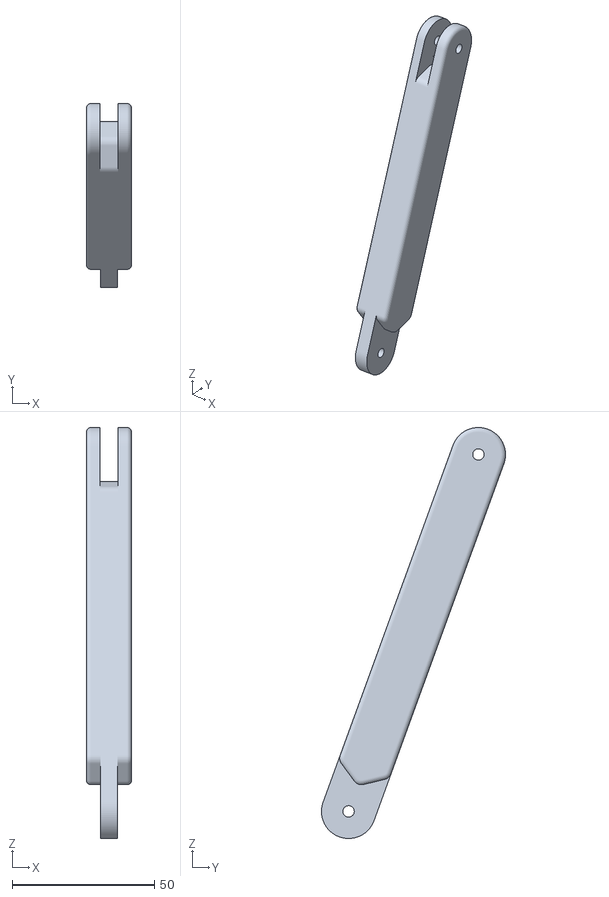
[picture p123: CAD file, 2025-10-06]
3d_models_corrections/tripod_arm.stl
15.9 x 64.7 x 144.4
