ni0x0/diploma/3d_models_corrections/Kegelrad_45.stl

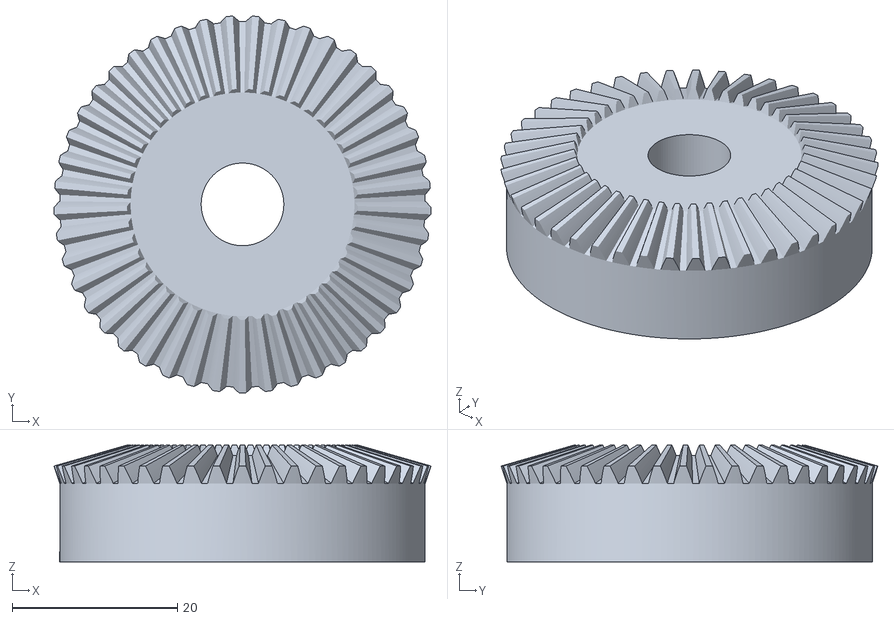
[picture p124: CAD file, 2025-10-06]
3d_models_corrections/Kegelrad_45.stl
45.6 x 45.6 x 14.2
