ni0x0/diploma/(list of files, cad)

Other CAD files:
project/panda_clouds/panda_cloud_270.ply
project/teapot_clouds/teapot_cloud_180.ply
project/panda_clouds/panda_cloud_120.ply
project/teapot_clouds/teapot_cloud_20.ply
project/panda_clouds/panda_cloud_0.ply
project/teapot_clouds/teapot_cloud_120.ply
project/panda_clouds/panda_cloud_330.ply
project/teapot_clouds/teapot_cloud_140.ply
project/panda_clouds/panda_cloud_180.ply
project/teapot_clouds/teapot_cloud_320.ply
project/panda_clouds/panda_cloud_60.ply
project/teapot_clouds/teapot_cloud_10.ply
project/panda_clouds/panda_cloud_30.ply
project/teapot_clouds/teapot_cloud_350.ply
project/panda_clouds/panda_cloud_150.ply
project/teapot_clouds/teapot_cloud_280.ply
project/panda_clouds/panda_cloud_90.ply
project/teapot_clouds/teapot_cloud_90.ply
project/panda_clouds/panda_cloud_300.ply
project/teapot_clouds/teapot_cloud_290.ply
project/panda_clouds/panda_cloud_210.ply
project/teapot_clouds/teapot_cloud_170.ply
project/panda_clouds/panda_cloud_240.ply
project/teapot_clouds/teapot_cloud_130.ply
project/teapot_clouds/teapot_cloud_30.ply
project/teapot_clouds/teapot_cloud_80.ply
project/teapot_clouds/teapot_cloud_210.ply
project/teapot_clouds/teapot_cloud_260.ply
project/teapot_clouds/teapot_cloud_150.ply
project/teapot_clouds/teapot_cloud_200.ply
project/teapot_clouds/teapot_cloud_310.ply
project/teapot_clouds/teapot_cloud_40.ply
project/teapot_clouds/teapot_cloud_250.ply
project/teapot_clouds/teapot_cloud_50.ply
project/teapot_clouds/teapot_cloud_160.ply
project/teapot_clouds/teapot_cloud_0.ply
project/teapot_clouds/teapot_cloud_110.ply
project/teapot_clouds/teapot_cloud_270.ply
project/teapot_clouds/teapot_cloud_230.ply
project/teapot_clouds/teapot_cloud_60.ply
project/teapot_clouds/teapot_cloud_100.ply
project/teapot_clouds/teapot_cloud_300.ply
project/teapot_clouds/teapot_cloud_240.ply
project/teapot_clouds/teapot_cloud_190.ply
project/teapot_clouds/teapot_cloud_70.ply
project/teapot_clouds/teapot_cloud_340.ply
project/teapot_clouds/teapot_cloud_330.ply
project/teapot_clouds/teapot_cloud_220.ply
3d_models_corrections/motor_holder.stl
