ni0x0/diploma/pcb/PCB_PCB_bms_2025-05-26.pdf

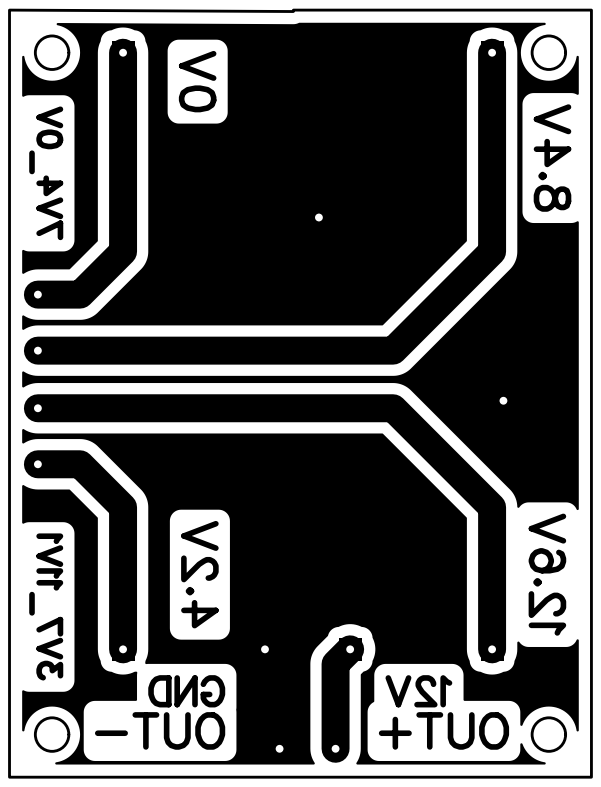
[picture p125: page 1]
