ni0x0/diploma/pcb/PCB_PCB_controller-copy_2025-05-29.pdf

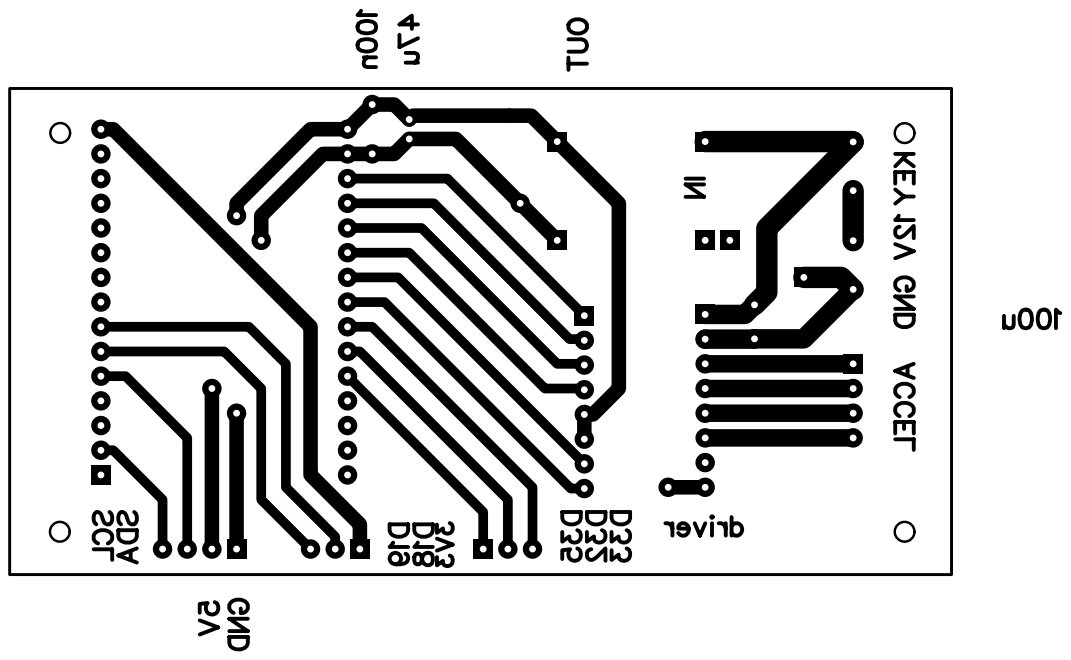
[picture p126: page 1]
