ni0x0/diploma/pcb/PCB_PCB_controller-copy_notes_2025-05-29.pdf

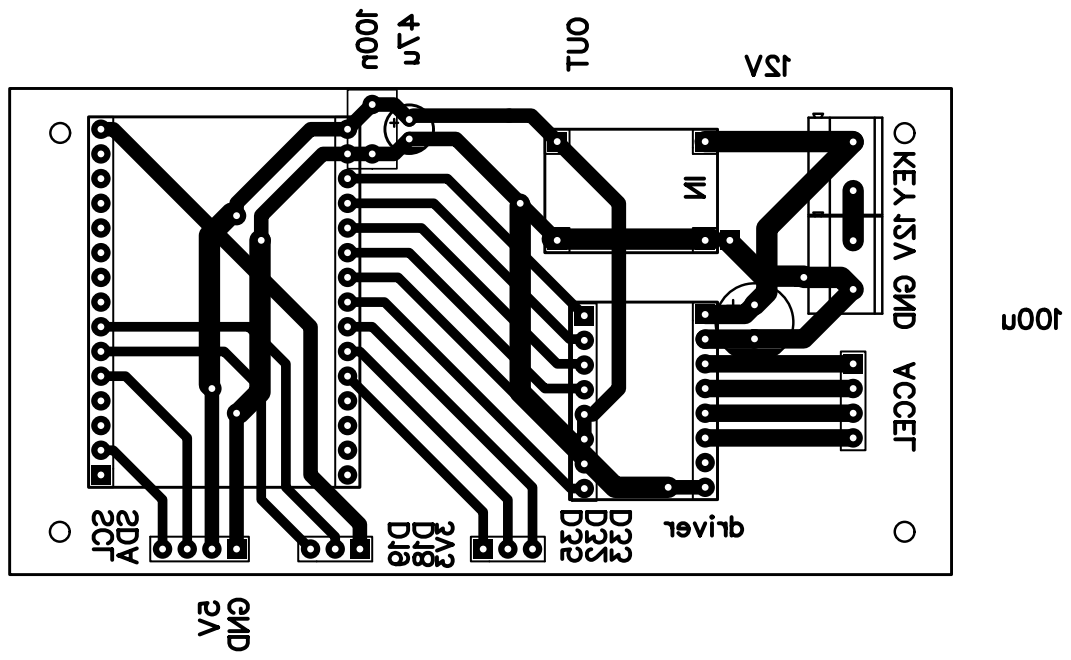
[picture p127: page 1]
