ni0x0/diploma/pcb/PCB_PCB_panel_2_2025-05-26.pdf

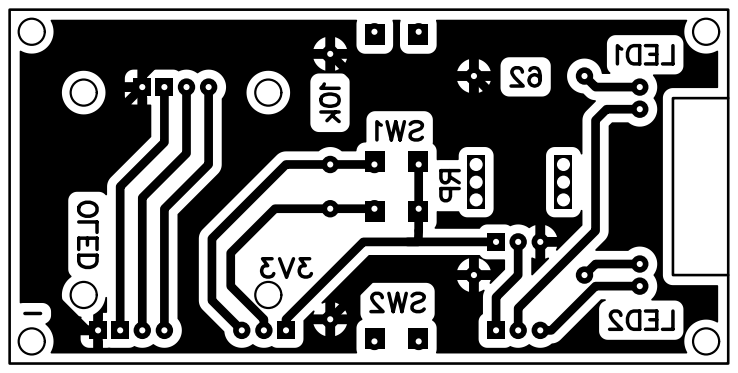
[picture p128: page 1]
