ni0x0/diploma/Documentation/DiplomaNotes/07_v2функцион+принцип.pdf

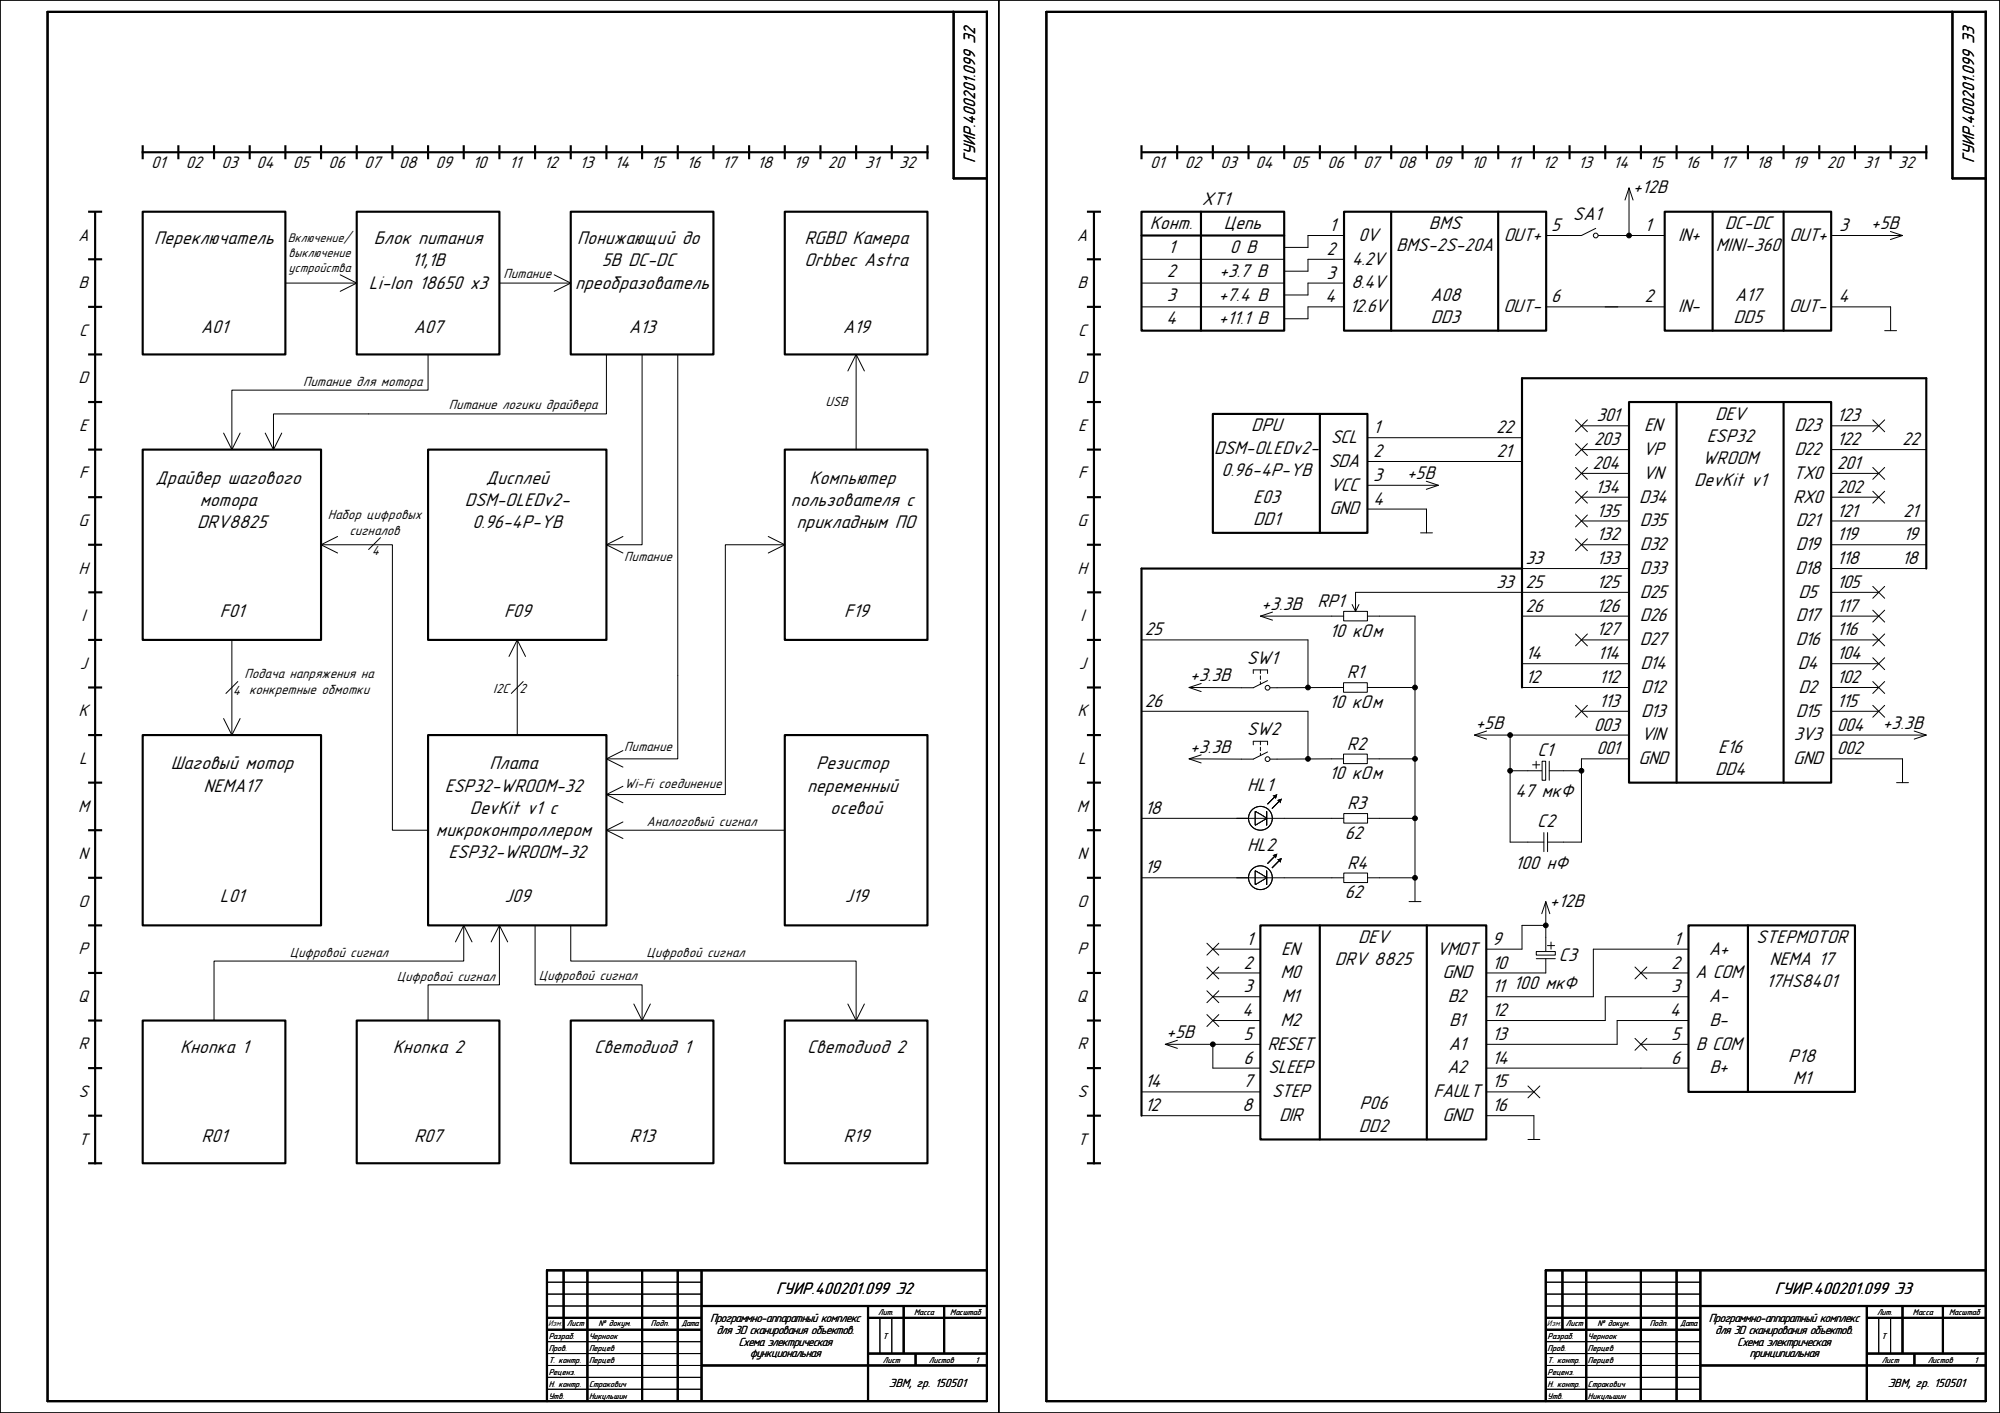
[picture p129: page 1]
