ni0x0/diploma/Documentation/DiplomaNotes/08_схема_мк.pdf

A

B

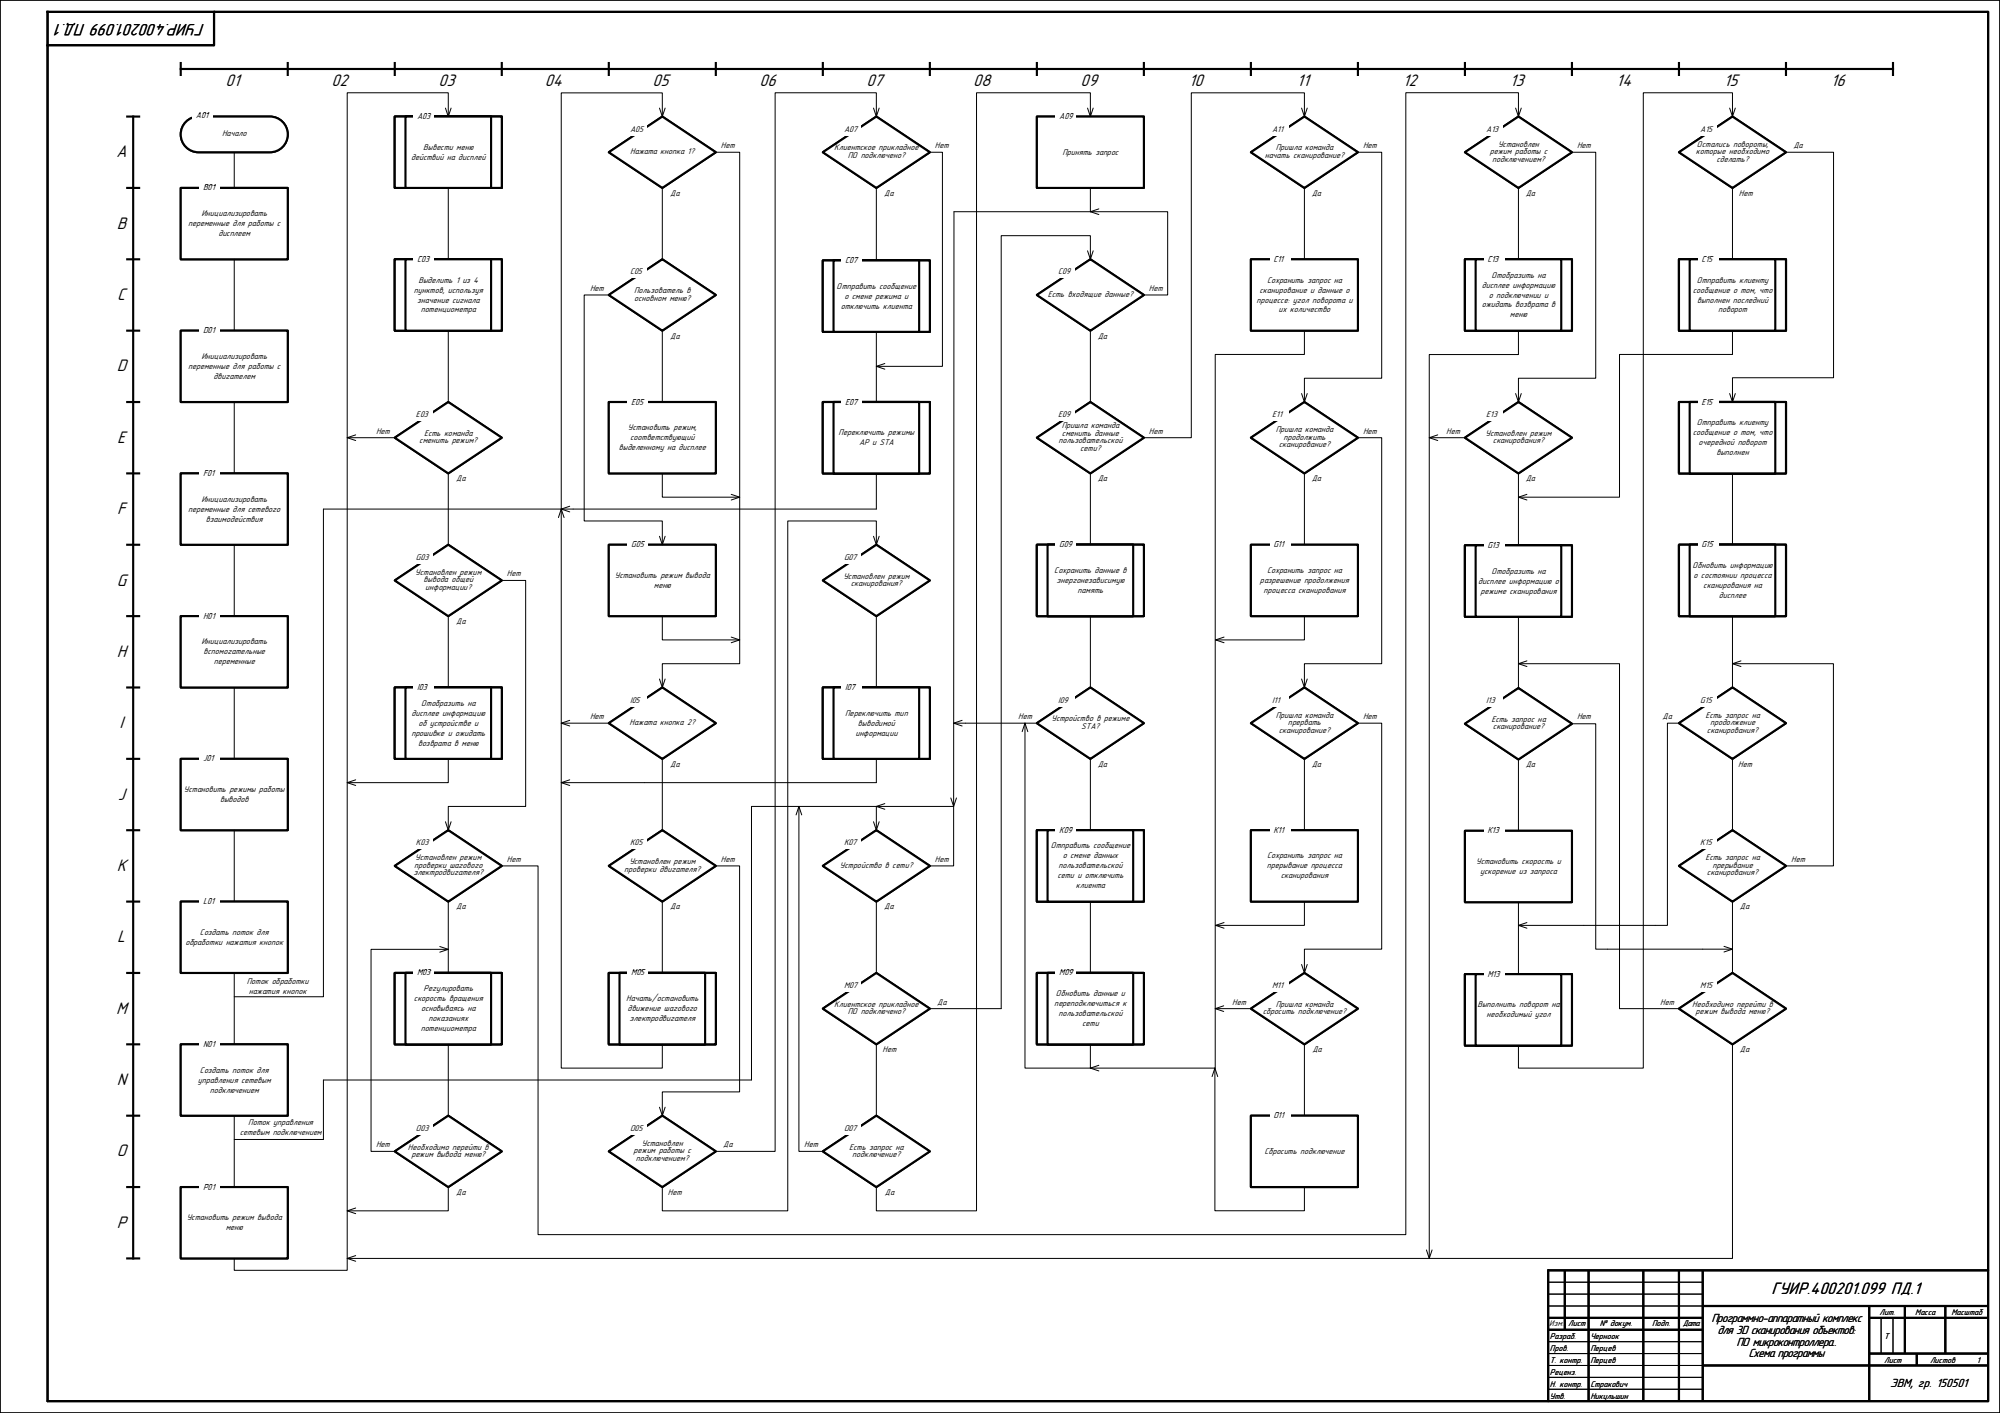
[picture p130: page 1]

ГУИР.400201.099 ПД.1

Программно-аппаратный комплекс Программно-аппаратный комплекс для 3D сканирования объектов: для 3D сканирования объектов: ПО микроконтроллера.. ПО микроконтроллера.. Схема программы Схема программы | Лит. | Масса | Масштаб

Изм. | Лист | № докум. | Подп. | Дата | | | Т Т
Разраб. | | Черноок
Пров. | | Перцев
Т. контр. | Перцев | | | | Лист | Листов Листов 1 1
Реценз. | | | | | ЭВМ, гр. 150501
Н. контр. | Стракович
Утв. | Никульшин
