ni0x0/diploma/Documentation/DiplomaNotes/09_схема_комп.pdf

A

B

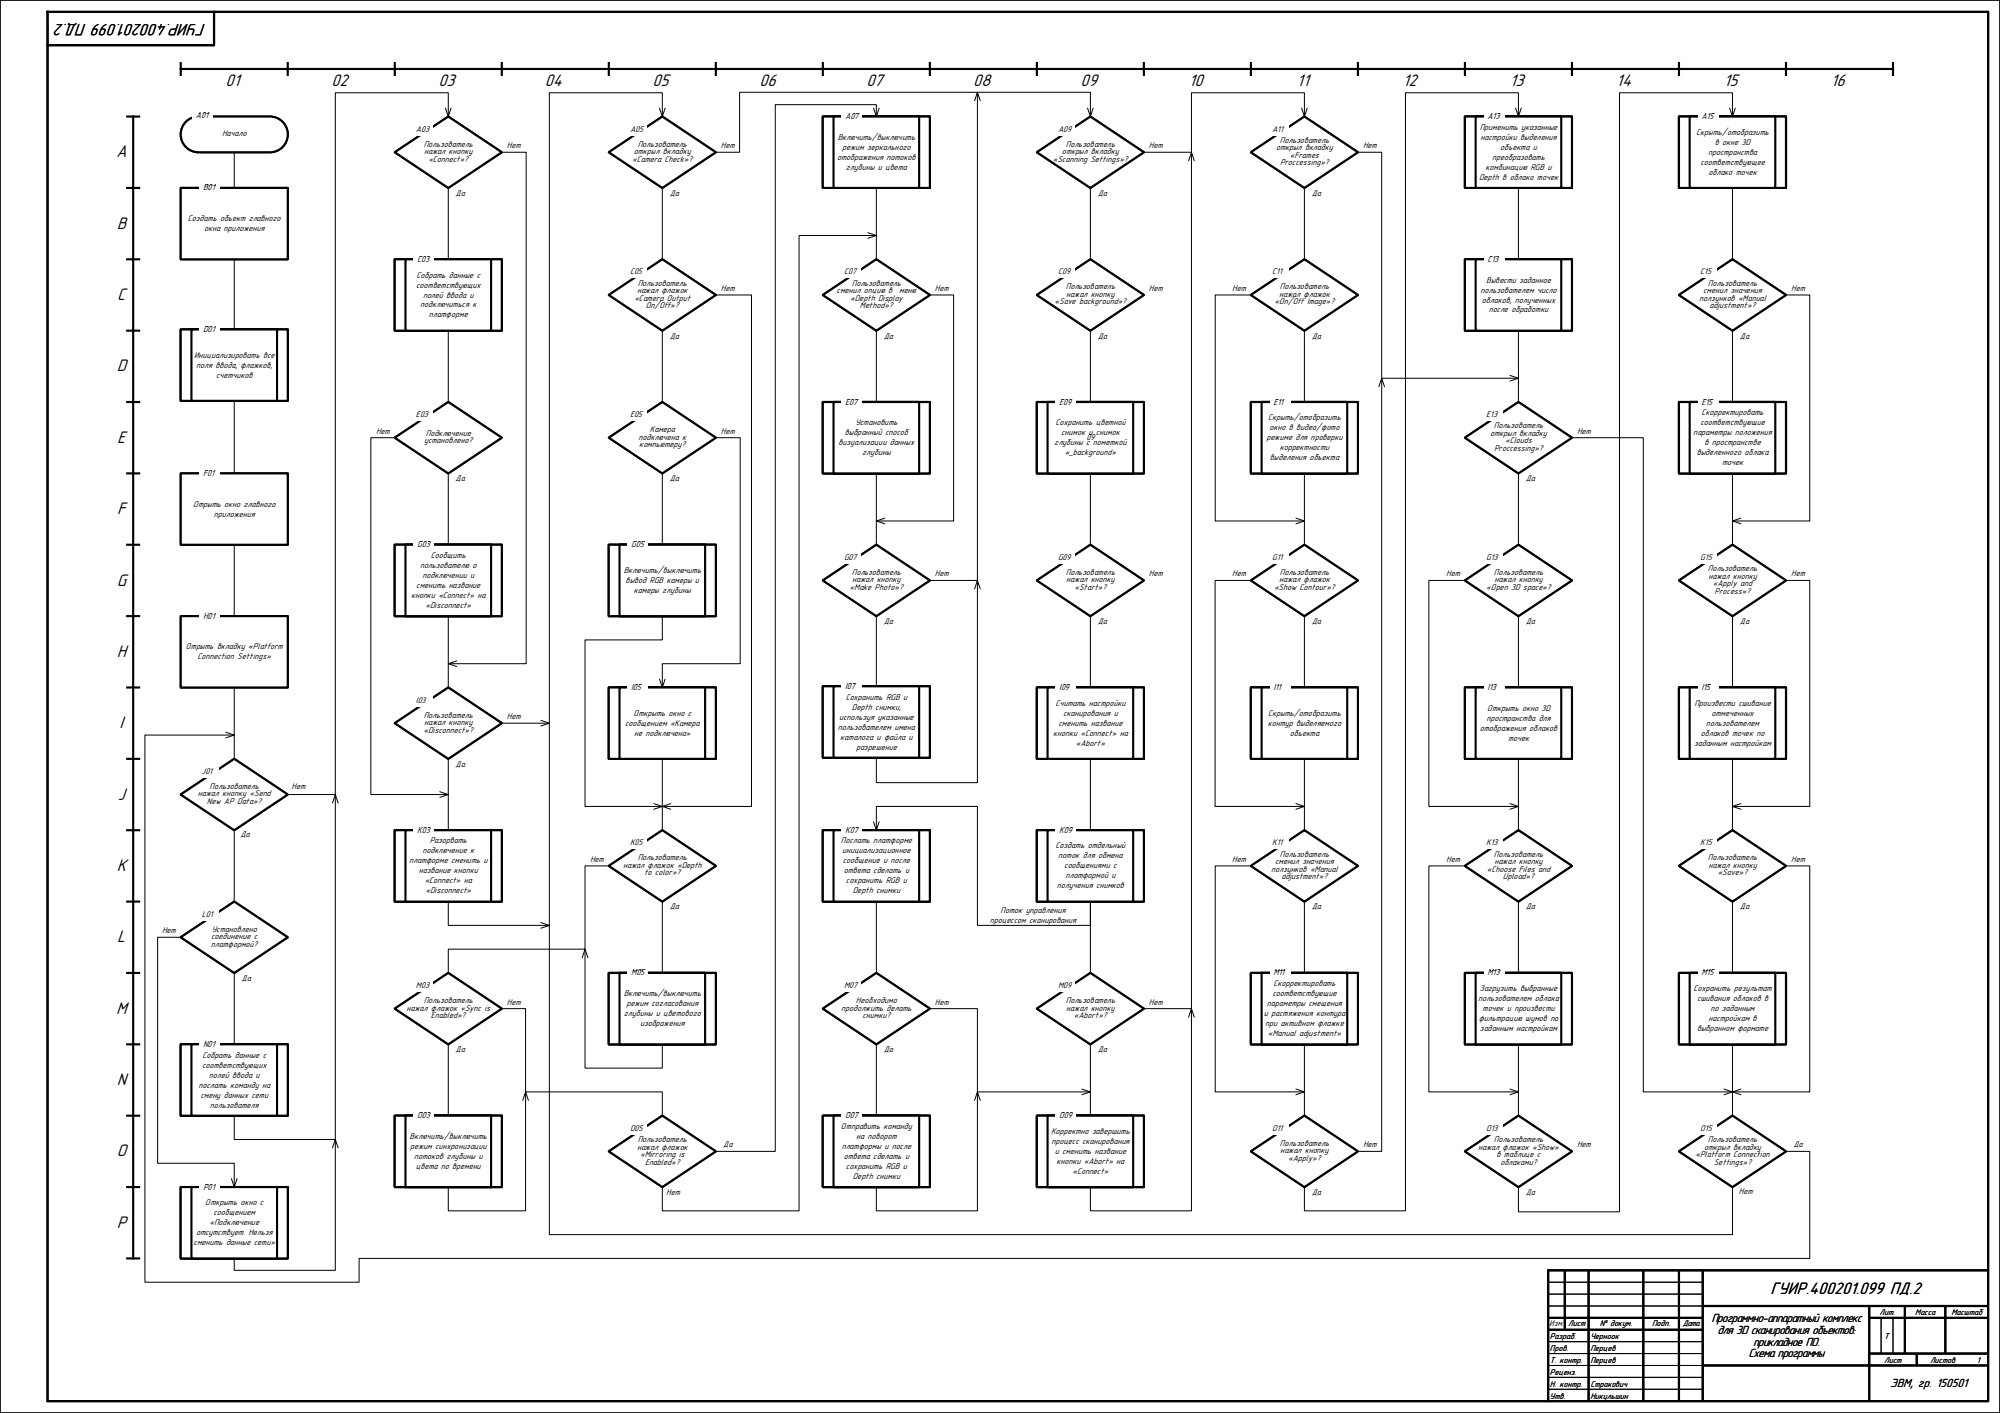
[picture p131: page 1]

Пользователь
нажал флажок «Sync is

ГУИР.400201.099 ПД.2

Программно-аппаратный комплекс Программно-аппаратный комплекс для 3D сканирования объектов: для 3D сканирования объектов: прикладное ПО. прикладное ПО. Схема программы Схема программы | Лит. | Масса | Масштаб

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
