ni0x0/diploma/(commit log)

2025-05-26 рабочая комиссия есть. остался проект
2025-10-06 not really beautifull but full
    [Kegelrad_45.stl, motor_holder.FCStd, motor_holder.stl, panda_cloud_0.ply, panda_cloud_120.ply, panda_cloud_150.ply, panda_cloud_180.ply, panda_cloud_210.ply]
